roryjamesallen/EuroPi/hardware/surface-mount/europi-surface-mount.kicad_pcb

## KiCad design hardware/surface-mount/europi-surface-mount.kicad_pcb (2026-04-23)

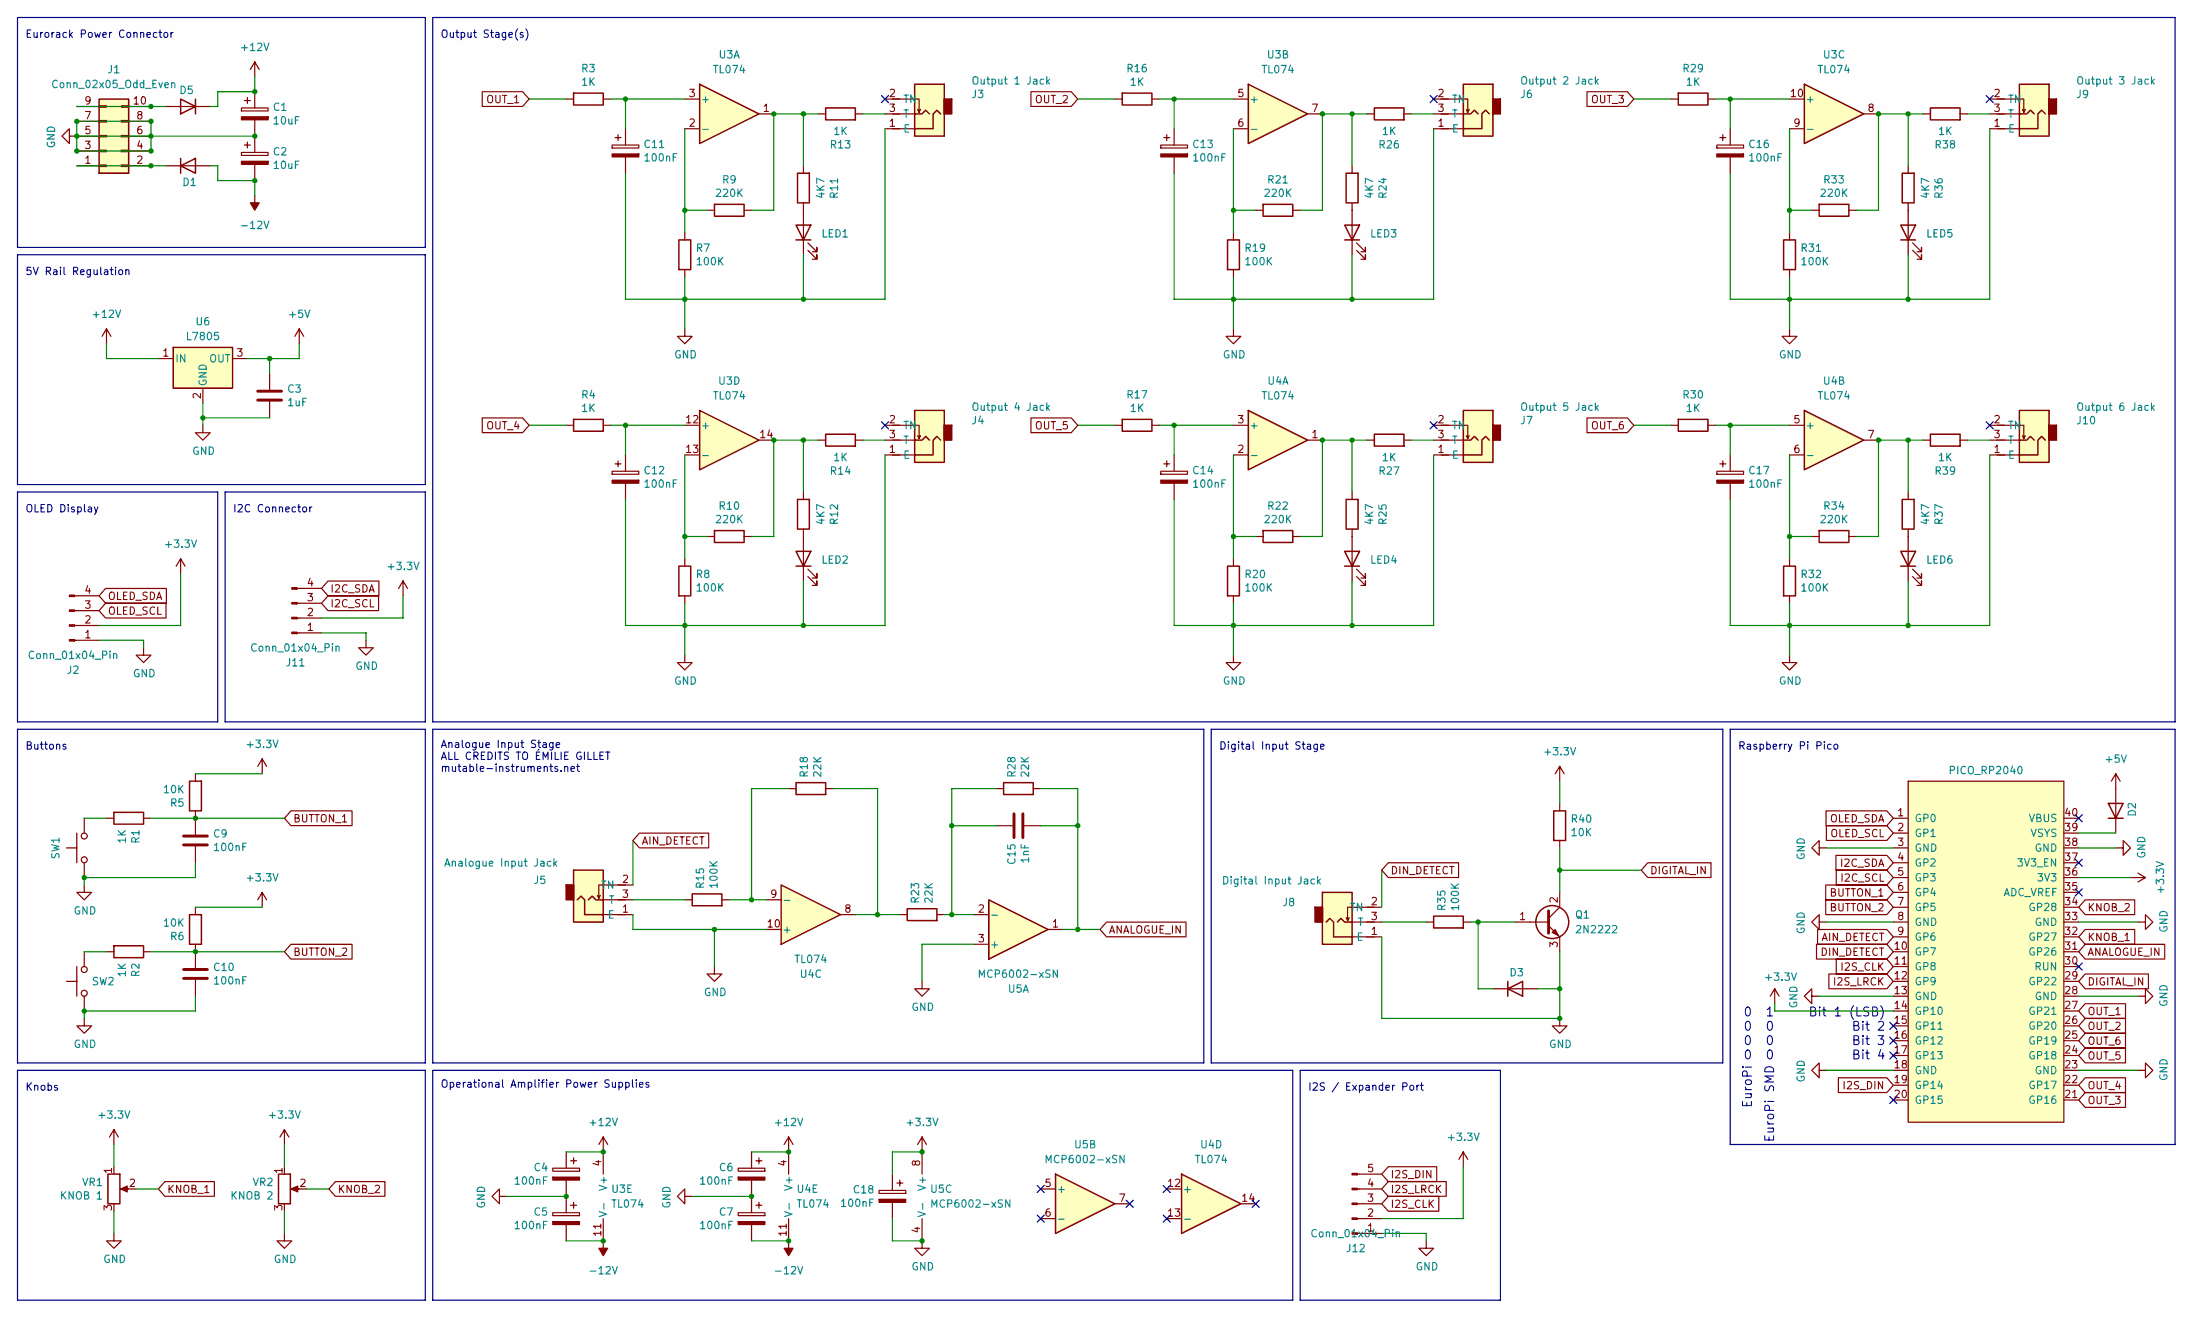
[picture p1: schematic europi-surface-mount.kicad_sch, EuroPi]

Parts:
C1, C2: 10uF; C_0805_2012Metric
C3: 1uF; C_0603_1608Metric
C4, C5, C6, C7, C9, C10, C11, C12, C13, C14, C16, C17, C18: 100nF; C_0603_1608Metric
C15: 1nF; C_0603_1608Metric
D1, D2, D5: D; D_SMA; LCSC Part C5356810
D3: D; D_SMA
J1: Conn_02x05_Odd_Even; power-header-10-pin-unlabelled
J2, J11: Conn_01x04_Pin; PinHeader_1x04_P2.54mm_Vertical
J3: Output 1 Jack; jack-thonkiconn-mono
J4: Output 4 Jack; jack-thonkiconn-mono
J5: Analogue Input Jack; jack-thonkiconn-mono
J6: Output 2 Jack; jack-thonkiconn-mono
J7: Output 5 Jack; jack-thonkiconn-mono
J8: Digital Input Jack; jack-thonkiconn-mono
J9: Output 3 Jack; jack-thonkiconn-mono
J10: Output 6 Jack; jack-thonkiconn-mono
J12: Conn_01x04_Pin; PinHeader_1x05_P2.54mm_Vertical
LED1, LED2, LED3, LED4, LED5, LED6: LED; led-3mm
Q1: 2N2222; SOT-89-3; LCSC Part C21714170
R1, R2, R3, R4, R13, R14, R16, R17, R26, R27, R29, R30, R38, R39: 1K; R_0603_1608Metric
R5, R6, R40: 10K; R_0603_1608Metric
R7, R8, R15, R19, R20, R31, R32, R35: 100K; R_0603_1608Metric
R9, R10, R21, R22, R33, R34: 220K; R_0603_1608Metric
R11, R12, R24, R25, R36, R37: 4K7; R_0603_1608Metric
R18, R23, R28: 22K; R_0603_1608Metric
SW1, SW2: SW_Push; switch-momentary-c&k
U2: PICO_RP2040; raspberry-pi-pico
U3, U4: TL074; SOIC-14_3.9x8.7mm_P1.27mm; LCSC Part C6963
U5: MCP6002-xSN; SOIC-8_3.9x4.9mm_P1.27mm; LCSC Part C7377
U6: L7805; TO-252-2; LCSC Part C7394043
VR1: KNOB 1; potentiometer-9mm
VR2: KNOB 2; potentiometer-9mm

Connections:
+3.3V: C18.1, J2.2, J11.2, J12.2, R5.2, R6.2, R40.1, U2.14 (GP10), U2.36 (3V3), U5.8 (V+), VR1.1, VR2.1
+5V: C3.1, D2.2 (A), U6.3 (OUT)
+12V: C1.1, C4.1, C6.1, D5.1 (K), U3.4 (V+), U4.4 (V+), U6.1 (IN)
-12V: C2.2, C5.2, C7.2, D1.2 (A), U3.11 (V-), U4.11 (V-)
AIN_DETECT: J5.2 (TN), U2.9 (GP6)
ANALOGUE_IN: C15.2, R28.2, U2.31 (GP26), U5.1
BUTTON_1: C9.1, R1.1, R5.1, U2.6 (GP4)
BUTTON_2: C10.1, R2.1, R6.1, U2.7 (GP5)
DIGITAL_IN: Q1.2 (C), R40.2, U2.29 (GP22)
DIN_DETECT: J8.2 (TN), U2.10 (GP7)
GND: C1.2, C2.1, C3.2, C4.2, C5.1, C6.2, C7.1, C9.2, C10.2, C11.2, C12.2, C13.2, C14.2, C16.2, C17.2, C18.2, D3.2 (A), J1.3, J1.4, J1.5, J1.6, J1.7, J1.8, J2.1, J3.1 (E), J4.1 (E), J5.1 (E), J6.1 (E), J7.1 (E), J8.1 (E), J9.1 (E), J10.1 (E), J11.1, J12.1, LED1.1 (K), LED2.1 (K), LED3.1 (K), LED4.1 (K), LED5.1 (K), LED6.1 (K), Q1.3 (E), R7.2, R8.2, R19.2, R20.2, R31.2, R32.2, SW1.1, SW2.1, U2.3 (GND), U2.8 (GND), U2.13 (GND), U2.18 (GND), U2.23 (GND), U2.28 (GND), U2.33 (GND), U2.38 (GND), U4.10 (+), U5.3 (+), U5.4 (V-), U6.2 (GND), VR1.3, VR2.3
I2C_SCL: J11.3, U2.5 (GP3)
I2C_SDA: J11.4, U2.4 (GP2)
I2S_CLK: J12.3, U2.11 (GP8)
I2S_DIN: J12.5, U2.19 (GP14)
I2S_LRCK: J12.4, U2.12 (GP9)
KNOB_1: U2.32 (GP27), VR1.2
KNOB_2: U2.34 (GP28), VR2.2
unnamed: D1.1 (K), J1.1, J1.2
unnamed: D2.1 (K), U2.39 (VSYS)
unnamed: D3.1 (K), Q1.1 (B), R35.2
unnamed: D5.2 (A), J1.9, J1.10
unnamed: J3.3 (T), R13.2
unnamed: J4.3 (T), R14.2
unnamed: J5.3 (T), R15.1
unnamed: J6.3 (T), R26.2
unnamed: J7.3 (T), R27.2
unnamed: J8.3 (T), R35.1
unnamed: J9.3 (T), R38.2
unnamed: J10.3 (T), R39.2
unnamed: LED1.2 (A), R11.1
unnamed: LED2.2 (A), R12.1
unnamed: LED3.2 (A), R24.1
unnamed: LED4.2 (A), R25.1
unnamed: LED5.2 (A), R36.1
unnamed: LED6.2 (A), R37.1
unnamed: R1.2, SW1.2
unnamed: R2.2, SW2.2
unnamed: R10.1, R12.2, R14.1, U3.14
unnamed: R9.1, R11.2, R13.1, U3.1
unnamed: R18.2, R23.1, U4.8
unnamed: R21.1, R24.2, R26.1, U3.7
unnamed: R22.1, R25.2, R27.1, U4.1
unnamed: R33.1, R36.2, R38.1, U3.8
unnamed: R34.1, R37.2, R39.1, U4.7
unnamed: C11.1, R3.1, U3.3 (+)
unnamed: R7.1, R9.2, U3.2 (-)
unnamed: C13.1, R16.1, U3.5 (+)
unnamed: R19.1, R21.2, U3.6 (-)
unnamed: C16.1, R29.1, U3.10 (+)
unnamed: R31.1, R33.2, U3.9 (-)
unnamed: C12.1, R4.1, U3.12 (+)
unnamed: R8.1, R10.2, U3.13 (-)
unnamed: C14.1, R17.1, U4.3 (+)
unnamed: R20.1, R22.2, U4.2 (-)
unnamed: C17.1, R30.1, U4.5 (+)
unnamed: R32.1, R34.2, U4.6 (-)
unnamed: R15.2, R18.1, U4.9 (-)
unnamed: C15.1, R23.2, R28.1, U5.2 (-)
OLED_SCL: J2.3, U2.2 (GP1)
OLED_SDA: J2.4, U2.1 (GP0)
OUT_1: R3.2, U2.27 (GP21)
OUT_2: R16.2, U2.26 (GP20)
OUT_3: R29.2, U2.21 (GP16)
OUT_4: R4.2, U2.22 (GP17)
OUT_5: R17.2, U2.24 (GP18)
OUT_6: R30.2, U2.25 (GP19)

Notes on the sheet:
Eurorack Power Connector
0 1 0 0 0 0 0 0
Operational Amplifier Power Supplies
Raspberry Pi Pico
Digital Input Stage
EuroPi SMD
5V Rail Regulation
Output Stage(s)
I2C Connector
I2S / Expander Port
Buttons
EuroPi
OLED Display
Analogue Input Stage ALL CREDITS TO ÉMILIE GILLET mutable-instruments.net
Knobs
Bit 1 (LSB) Bit 2 Bit 3 Bit 4

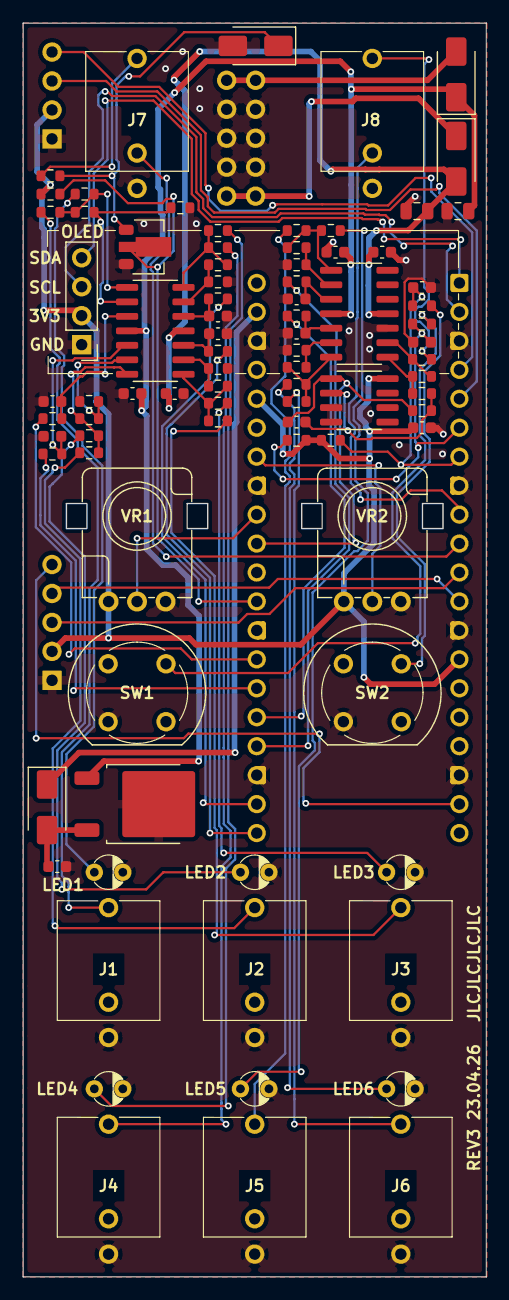
[picture p2: board europi-surface-mount.kicad_pcb from above]

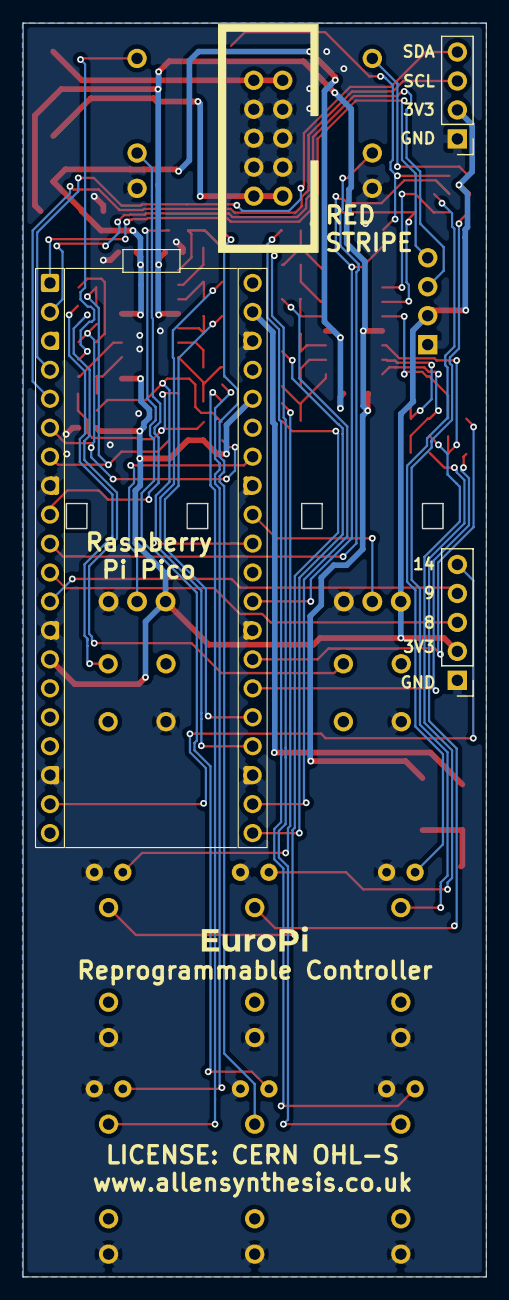
[picture p3: board europi-surface-mount.kicad_pcb from below]

Board: 2 copper layers, 40.6 x 110.0 mm, 89 parts (4 on the bottom side), 67 nets.
