roryjamesallen/EuroPi/hardware/EuroPi-X/development/output stage/output stage.kicad_pcb

## KiCad design hardware/EuroPi-X/development/output stage/output stage.kicad_pcb (2024-01-31)

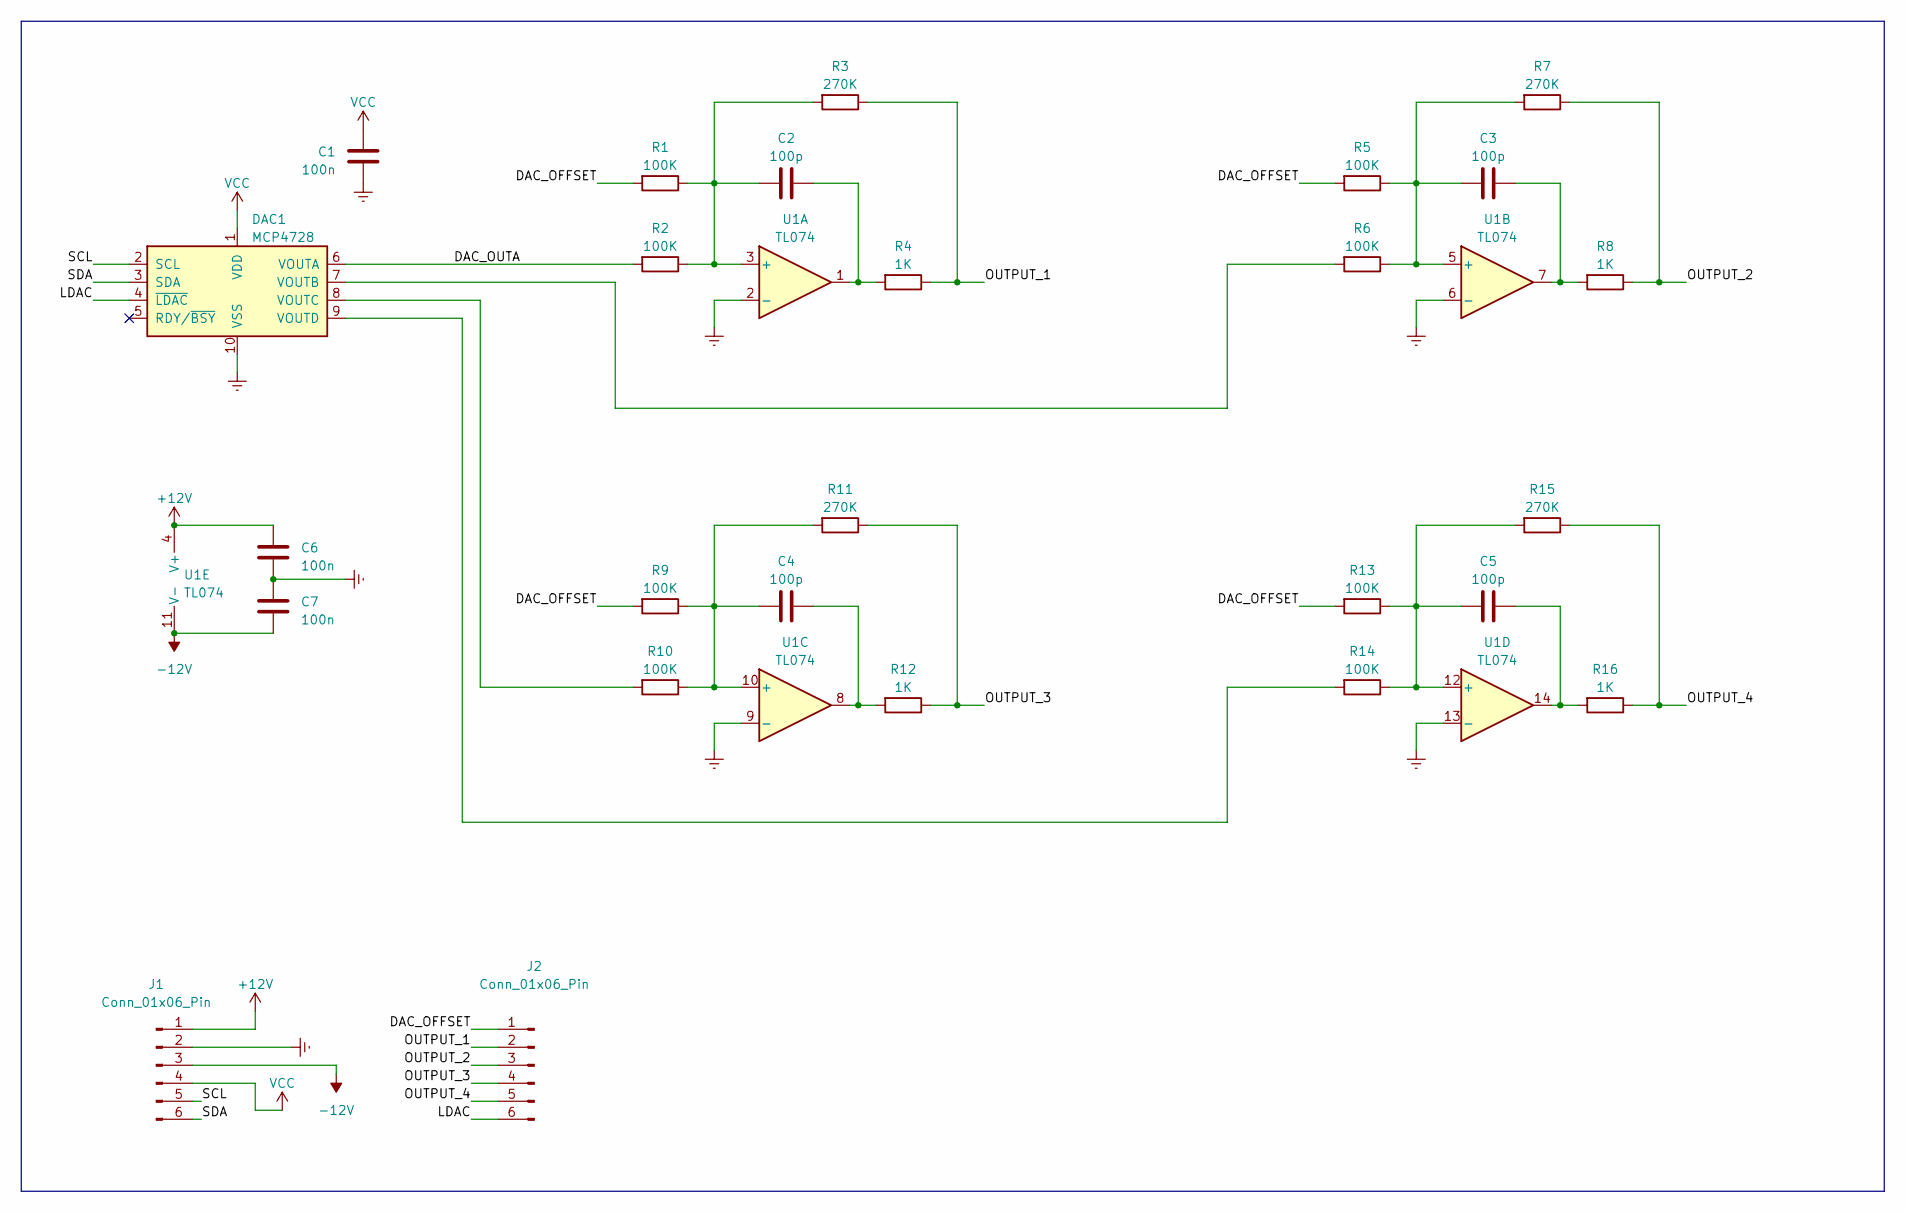
[picture p4: schematic output stage.kicad_sch]

Parts:
C1, C6, C7: 100n; C_0402_1005Metric; JLC C1525
C2, C3, C4, C5: 100p; C_0402_1005Metric; JLC C1546
DAC1: MCP4728; MSOP-10_3x3mm_P0.5mm; JLC C478093
J1, J2: Conn_01x06_Pin; PinHeader_1x06_P2.54mm_Vertical
R1, R2, R5, R6, R9, R10, R13, R14: 100K; R_0402_1005Metric; JLC C25741
R3, R7, R11, R15: 270K; R_0402_1005Metric; JLC C170277
R4, R8, R12, R16: 1K; R_0402_1005Metric; JLC C11702
U1: TL074; SOIC-14_3.9x8.7mm_P1.27mm; JLC C6963

Connections:
+12V: C6.1, J1.1, U1.4 (V+)
-12V: C7.2, J1.3, U1.11 (V-)
/DAC_OFFSET: J2.1, R1.2, R5.2, R9.2, R13.2
/DAC_OUTA: DAC1.6 (VOUTA), R2.2
/LDAC: DAC1.4 (~LDAC), J2.6
/OUTPUT_1: J2.2, R3.1, R4.1
/OUTPUT_2: J2.3, R7.1, R8.1
/OUTPUT_3: J2.4, R11.1, R12.1
/OUTPUT_4: J2.5, R15.1, R16.1
/SCL: DAC1.2 (SCL), J1.5
/SDA: DAC1.3 (SDA), J1.6
Earth: C1.2, C6.2, C7.1, DAC1.10 (VSS), J1.2, U1.2 (-), U1.6 (-), U1.9 (-), U1.13 (-)
unnamed: C2.2, R4.2, U1.1
unnamed: C3.2, R8.2, U1.7
unnamed: C4.2, R12.2, U1.8
unnamed: C5.2, R16.2, U1.14
unnamed: DAC1.7 (VOUTB), R6.2
unnamed: DAC1.8 (VOUTC), R10.2
unnamed: DAC1.9 (VOUTD), R14.2
unnamed: C2.1, R1.1, R2.1, R3.2, U1.3 (+)
unnamed: C3.1, R5.1, R6.1, R7.2, U1.5 (+)
unnamed: C4.1, R9.1, R10.1, R11.2, U1.10 (+)
unnamed: C5.1, R13.1, R14.1, R15.2, U1.12 (+)
VCC: C1.1, DAC1.1 (VDD), J1.4

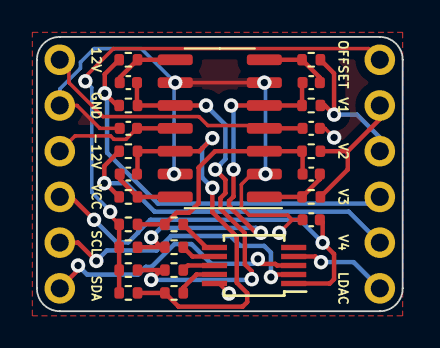
[picture p5: board output stage.kicad_pcb from above]

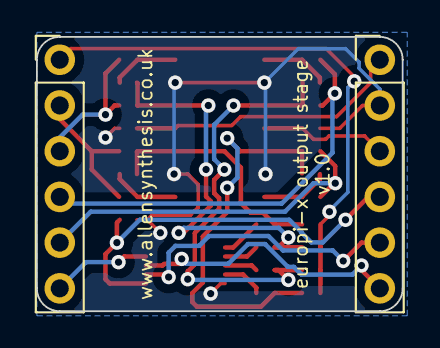
[picture p6: board output stage.kicad_pcb from below]

Board: 2 copper layers, 20.3 x 15.2 mm, 27 parts (2 on the bottom side), 24 nets.
