roryjamesallen/EuroPi/hardware/EuroPi-X/development/jack pcb/jack pcb.kicad_pcb

## KiCad design hardware/EuroPi-X/development/jack pcb/jack pcb.kicad_pcb (2024-01-25)

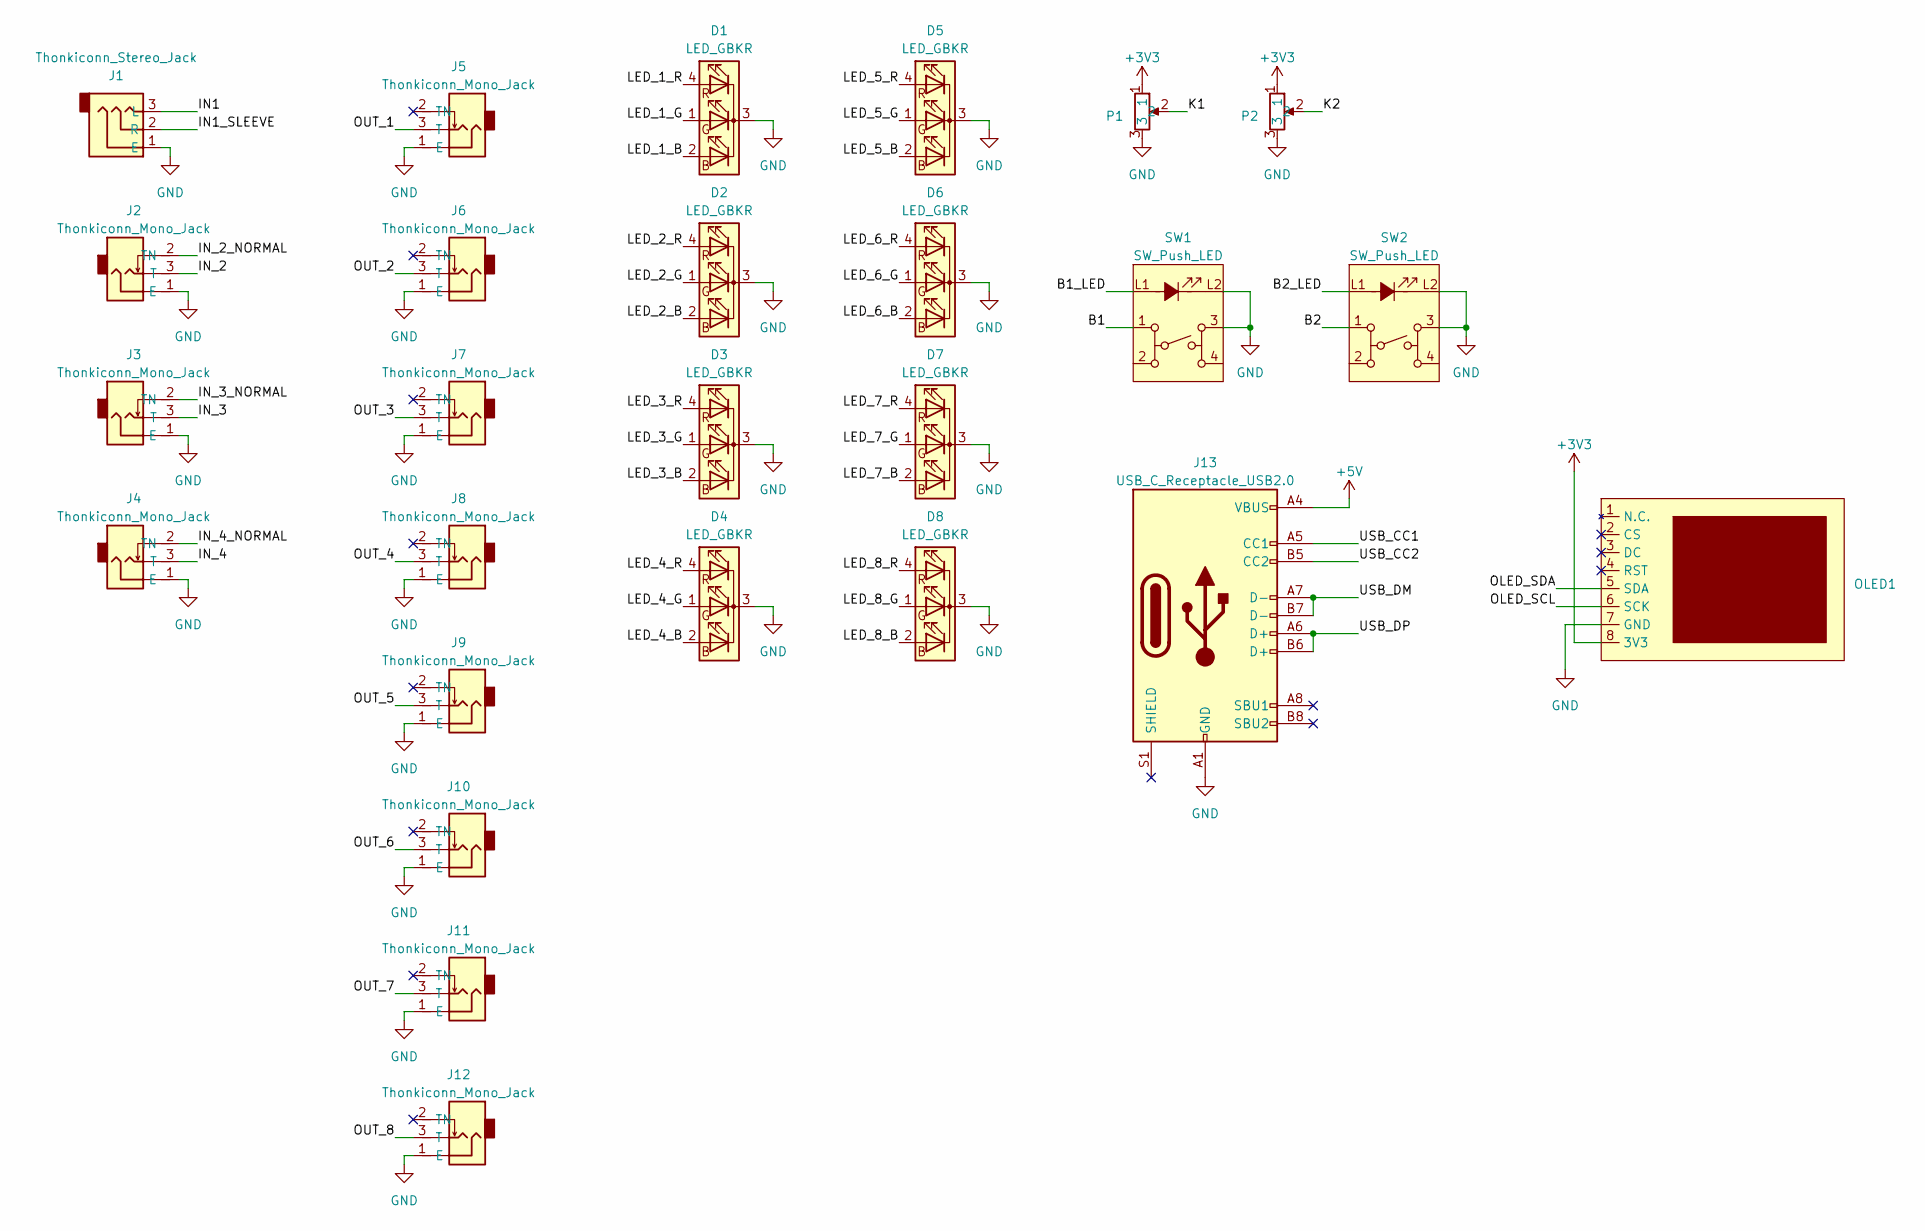
[picture p9: schematic jack pcb.kicad_sch]

Parts:
D1, D2, D3, D4, D5, D6, D7, D8: LED_GBKR; 254-5726 RGB Led 5mm
J1: Thonkiconn_Stereo_Jack; Thonkiconn Stereo Jack
J2, J3, J4, J5, J6, J7, J8, J9, J10, J11, J12: Thonkiconn_Mono_Jack; Thonkiconn Mono Jack
J13: USB_C_Receptacle_USB2.0; USB_C_Vertical_GT-USB-7038X USB
OLED1: Enoki OLED SSD1306 128x64
P1, P2: Potentiometer_9mm_Vertical_Linear; potentiometer-9mm_2hp
SW1, SW2: SW_Push_LED; switch-momentary-c&k-illuminated

Connections:
+3V3: OLED1.8 (3V3), P1.1, P2.1
+5V: J13.A4 (VBUS), J13.A9 (VBUS), J13.B4 (VBUS), J13.B9 (VBUS)
/B1: SW1.1
/B1_LED: SW1.L1 (A)
/B2: SW2.1
/B2_LED: SW2.L1 (A)
/IN1: J1.3 (L)
/IN1_SLEEVE: J1.2 (R)
/IN_2: J2.3 (T)
/IN_2_NORMAL: J2.2 (TN)
/IN_3: J3.3 (T)
/IN_3_NORMAL: J3.2 (TN)
/IN_4: J4.3 (T)
/IN_4_NORMAL: J4.2 (TN)
/K1: P1.2
/K2: P2.2
/LED_1_B: D1.2 (BA)
/LED_1_G: D1.1 (GA)
/LED_1_R: D1.4 (RA)
/LED_2_B: D2.2 (BA)
/LED_2_G: D2.1 (GA)
/LED_2_R: D2.4 (RA)
/LED_3_B: D3.2 (BA)
/LED_3_G: D3.1 (GA)
/LED_3_R: D3.4 (RA)
/LED_4_B: D4.2 (BA)
/LED_4_G: D4.1 (GA)
/LED_4_R: D4.4 (RA)
/LED_5_B: D5.2 (BA)
/LED_5_G: D5.1 (GA)
/LED_5_R: D5.4 (RA)
/LED_6_B: D6.2 (BA)
/LED_6_G: D6.1 (GA)
/LED_6_R: D6.4 (RA)
/LED_7_B: D7.2 (BA)
/LED_7_G: D7.1 (GA)
/LED_7_R: D7.4 (RA)
/LED_8_B: D8.2 (BA)
/LED_8_G: D8.1 (GA)
/LED_8_R: D8.4 (RA)
/OLED_SCL: OLED1.6 (SCK)
/OLED_SDA: OLED1.5 (SDA)
/OUT_1: J5.3 (T)
/OUT_2: J6.3 (T)
/OUT_3: J7.3 (T)
/OUT_4: J8.3 (T)
/OUT_5: J9.3 (T)
/OUT_6: J10.3 (T)
/OUT_7: J11.3 (T)
/OUT_8: J12.3 (T)
/USB_CC1: J13.A5 (CC1)
/USB_CC2: J13.B5 (CC2)
/USB_DM: J13.A7 (D-), J13.B7 (D-)
/USB_DP: J13.A6 (D+), J13.B6 (D+)
GND: D1.3 (K), D2.3 (K), D3.3 (K), D4.3 (K), D5.3 (K), D6.3 (K), D7.3 (K), D8.3 (K), J1.1 (E), J2.1 (E), J3.1 (E), J4.1 (E), J5.1 (E), J6.1 (E), J7.1 (E), J8.1 (E), J9.1 (E), J10.1 (E), J11.1 (E), J12.1 (E), J13.A1 (GND), J13.A12 (GND), J13.B1 (GND), J13.B12 (GND), OLED1.7 (GND), P1.3, P2.3, SW1.3, SW1.L2 (K), SW2.3, SW2.L2 (K)

Board: 2 copper layers, 26 parts (0 on the bottom side), 5 nets, no tracks yet.
