roryjamesallen/EuroPi/hardware/EuroPi-X/development/neopixels/neopixels.kicad_pcb

## KiCad design hardware/EuroPi-X/development/neopixels/neopixels.kicad_pcb (2024-01-21)

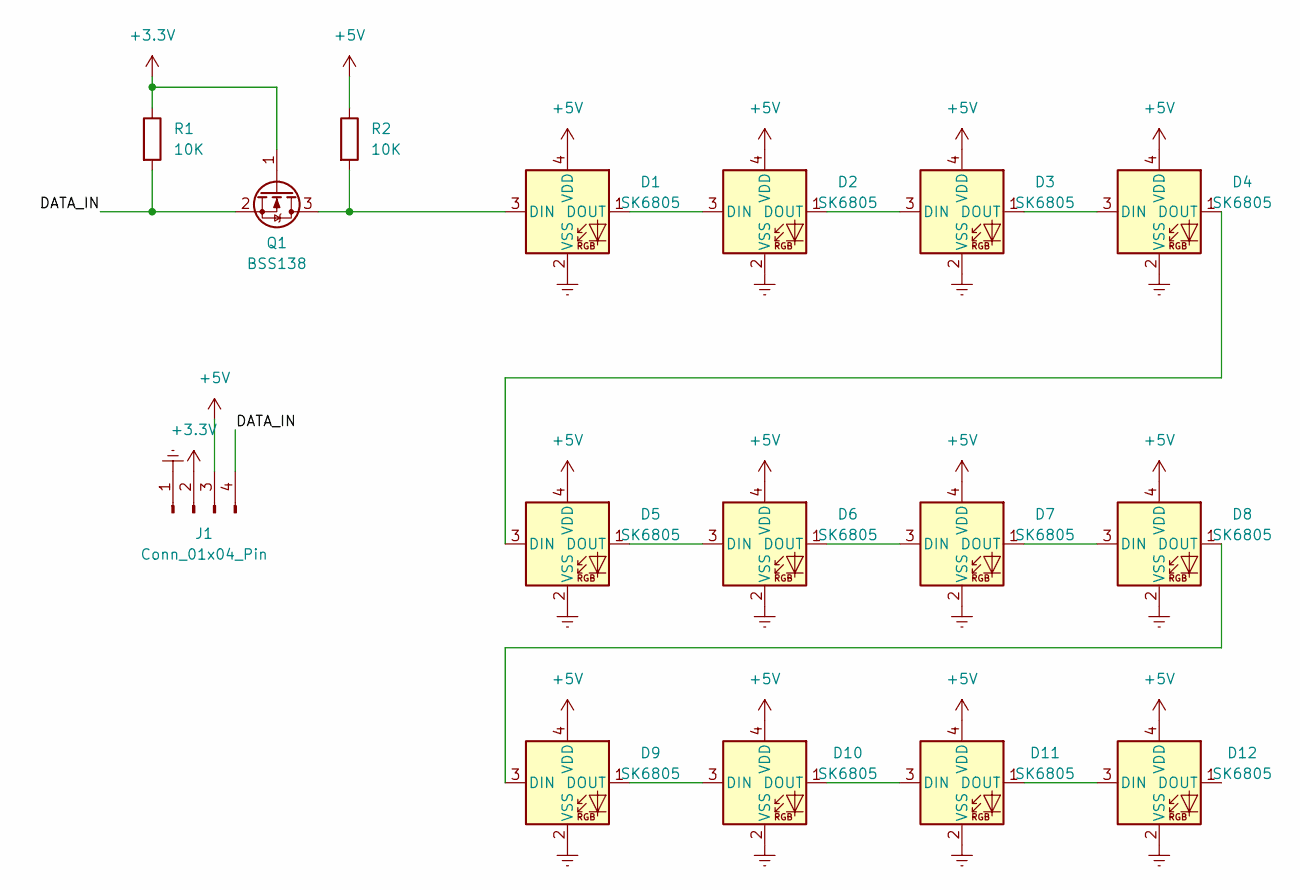
[picture p10: schematic neopixels.kicad_sch]

Parts:
D1, D2, D3, D4, D5, D6, D7, D8, D9, D10, D11, D12: SK6805; LED_SK6805_PLCC4_2.4x2.7mm_P1.3mm; JLC C2890036
J1: Conn_01x04_Pin; PinHeader_1x04_P2.54mm_Vertical
Q1: BSS138; SOT-23
R1, R2: 10K; R_0402_1005Metric; JLC C25744

Connections:
+3.3V: J1.2, Q1.1 (G), R1.1
+5V: D1.4 (VDD), D2.4 (VDD), D3.4 (VDD), D4.4 (VDD), D5.4 (VDD), D6.4 (VDD), D7.4 (VDD), D8.4 (VDD), D9.4 (VDD), D10.4 (VDD), D11.4 (VDD), D12.4 (VDD), J1.3, R2.1
/DATA_IN: J1.4, Q1.2 (S), R1.2
Earth: D1.2 (VSS), D2.2 (VSS), D3.2 (VSS), D4.2 (VSS), D5.2 (VSS), D6.2 (VSS), D7.2 (VSS), D8.2 (VSS), D9.2 (VSS), D10.2 (VSS), D11.2 (VSS), D12.2 (VSS), J1.1
unnamed: D1.3 (DIN), Q1.3 (D), R2.2
unnamed: D1.1 (DOUT), D2.3 (DIN)
unnamed: D2.1 (DOUT), D3.3 (DIN)
unnamed: D3.1 (DOUT), D4.3 (DIN)
unnamed: D4.1 (DOUT), D5.3 (DIN)
unnamed: D5.1 (DOUT), D6.3 (DIN)
unnamed: D6.1 (DOUT), D7.3 (DIN)
unnamed: D7.1 (DOUT), D8.3 (DIN)
unnamed: D8.1 (DOUT), D9.3 (DIN)
unnamed: D9.1 (DOUT), D10.3 (DIN)
unnamed: D10.1 (DOUT), D11.3 (DIN)
unnamed: D11.1 (DOUT), D12.3 (DIN)

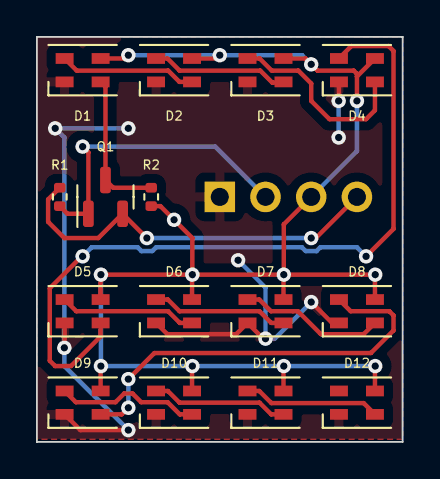
[picture p11: board neopixels.kicad_pcb from above]

Board: 2 copper layers, 20.3 x 22.5 mm, 16 parts (1 on the bottom side), 16 nets.
