roryjamesallen/EuroPi/hardware/EuroPi-X/development/analogue_switches/analogue_switches.kicad_pcb

## KiCad design hardware/EuroPi-X/development/analogue_switches/analogue_switches.kicad_pcb (2024-01-15)

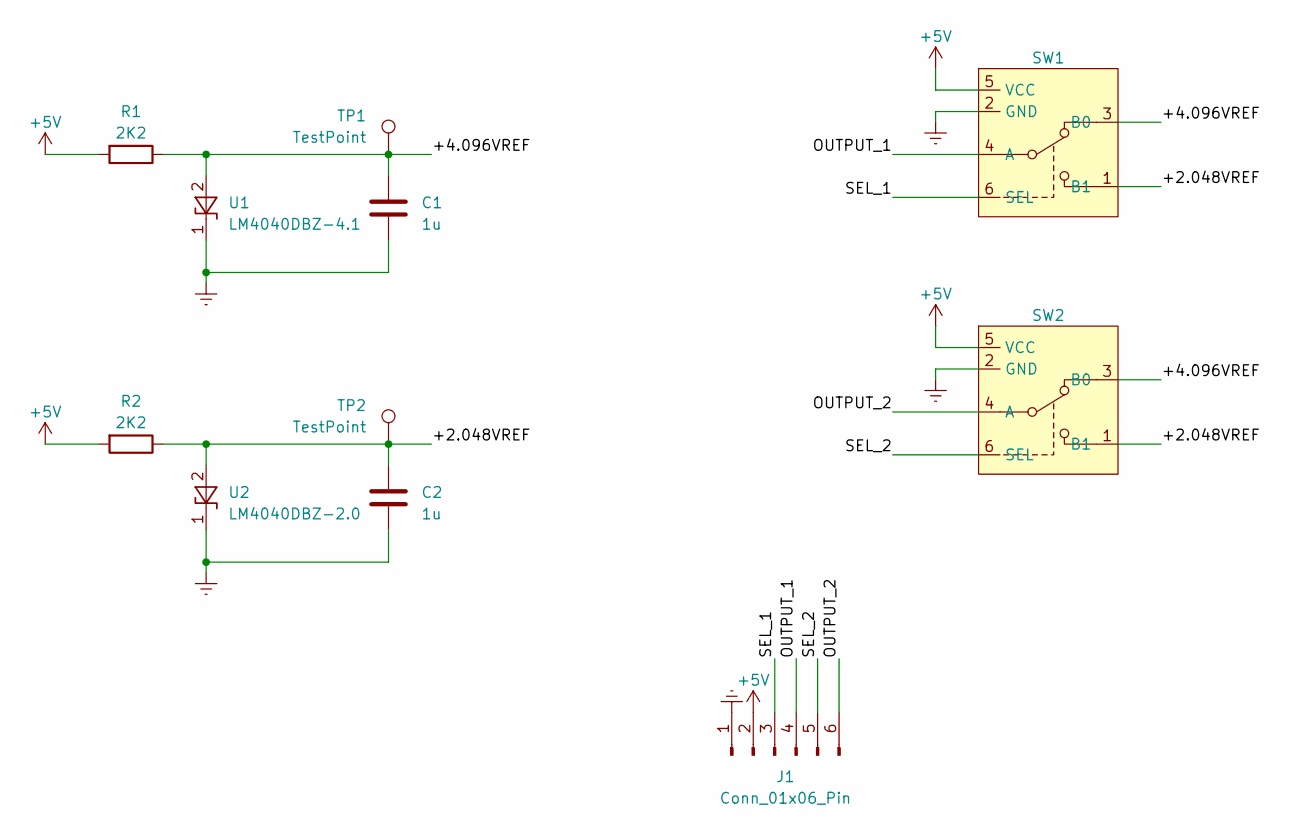
[picture p12: schematic analogue_switches.kicad_sch]

Parts:
C1, C2: 1u; C_0402_1005Metric; JLC C52923
J1: Conn_01x06_Pin; PinHeader_1x06_P2.54mm_Vertical
R1, R2: 2K2; R_0402_1005Metric; JLC C25879
SW1, SW2: SOT-363_SC-70-6; JLC C213161
TP1, TP2: TestPoint; TestPoint_Pad_2.0x2.0mm
U1: LM4040DBZ-4.1; SOT-23; JLC C202194
U2: LM4040DBZ-2.0; SOT-23; JLC C144273

Connections:
+5V: J1.2, R1.2, R2.2, SW1.5 (VCC), SW2.5 (VCC)
/+2.048VREF: C2.1, R2.1, SW1.1 (B1), SW2.1 (B1), TP2.1, U2.2 (A)
/+4.096VREF: C1.1, R1.1, SW1.3 (B0), SW2.3 (B0), TP1.1, U1.2 (A)
/OUTPUT_1: J1.4, SW1.4 (A)
/OUTPUT_2: J1.6, SW2.4 (A)
/SEL_1: J1.3, SW1.6 (SEL)
/SEL_2: J1.5, SW2.6 (SEL)
Earth: C1.2, C2.2, J1.1, SW1.2 (GND), SW2.2 (GND), U1.1 (K), U2.1 (K)

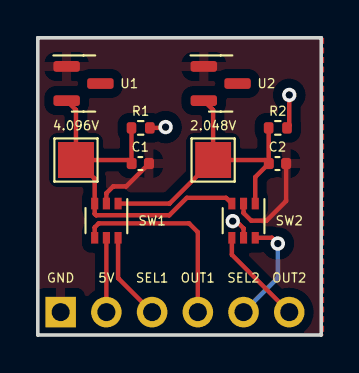
[picture p13: board analogue_switches.kicad_pcb from above]

Board: 2 copper layers, 15.7 x 16.5 mm, 11 parts (1 on the bottom side), 8 nets.
