roryjamesallen/EuroPi/hardware/EuroPi-X/kicad/EuroPi-X.kicad_pcb

## KiCad design hardware/EuroPi-X/kicad/EuroPi-X.kicad_pcb (2023-05-05)

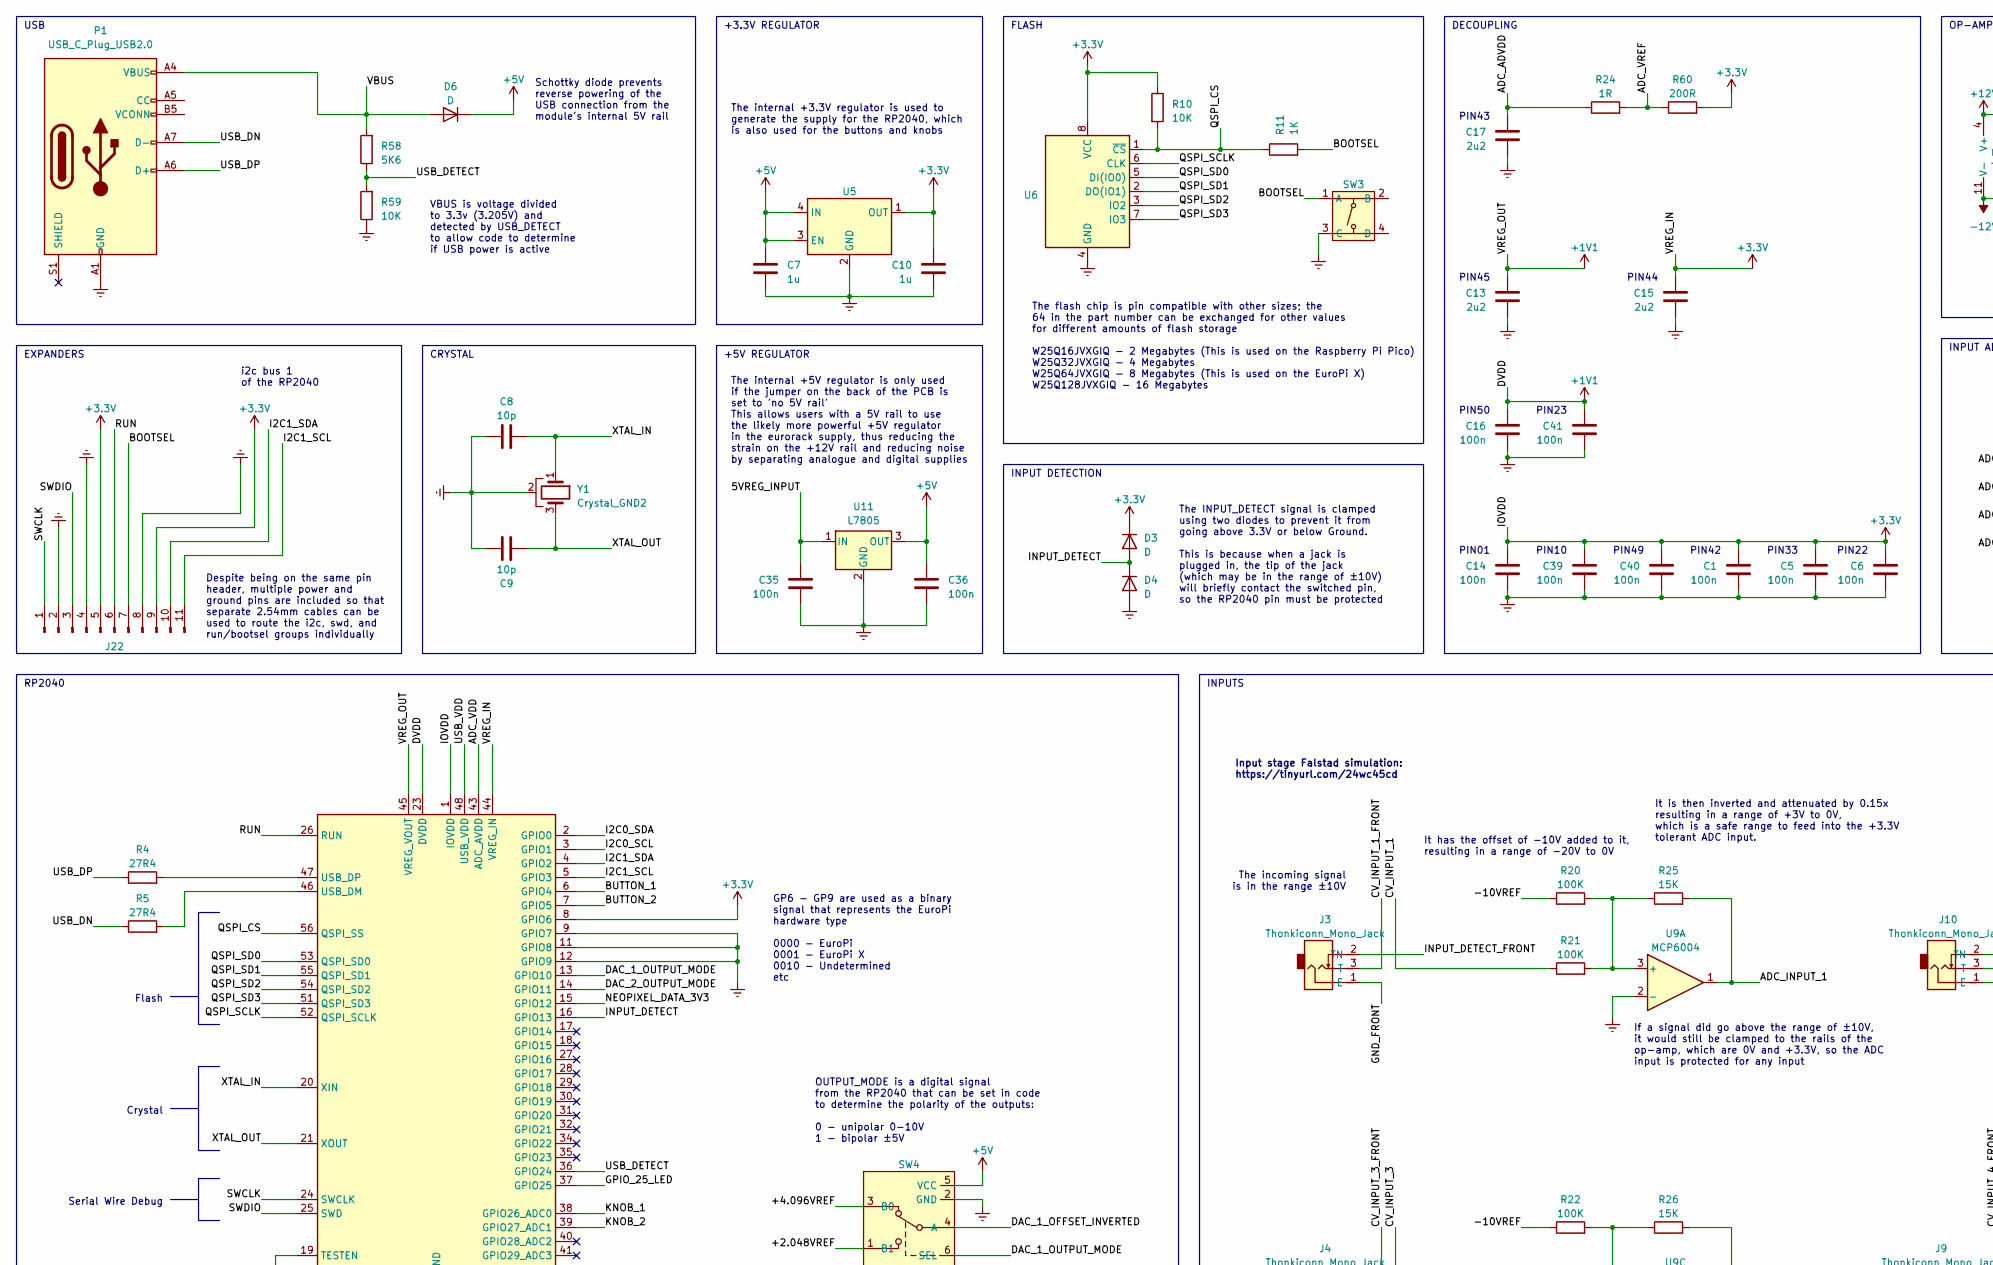
[picture p14: schematic EuroPi-X.kicad_sch, EuroPi X, part in row 1, column 1]

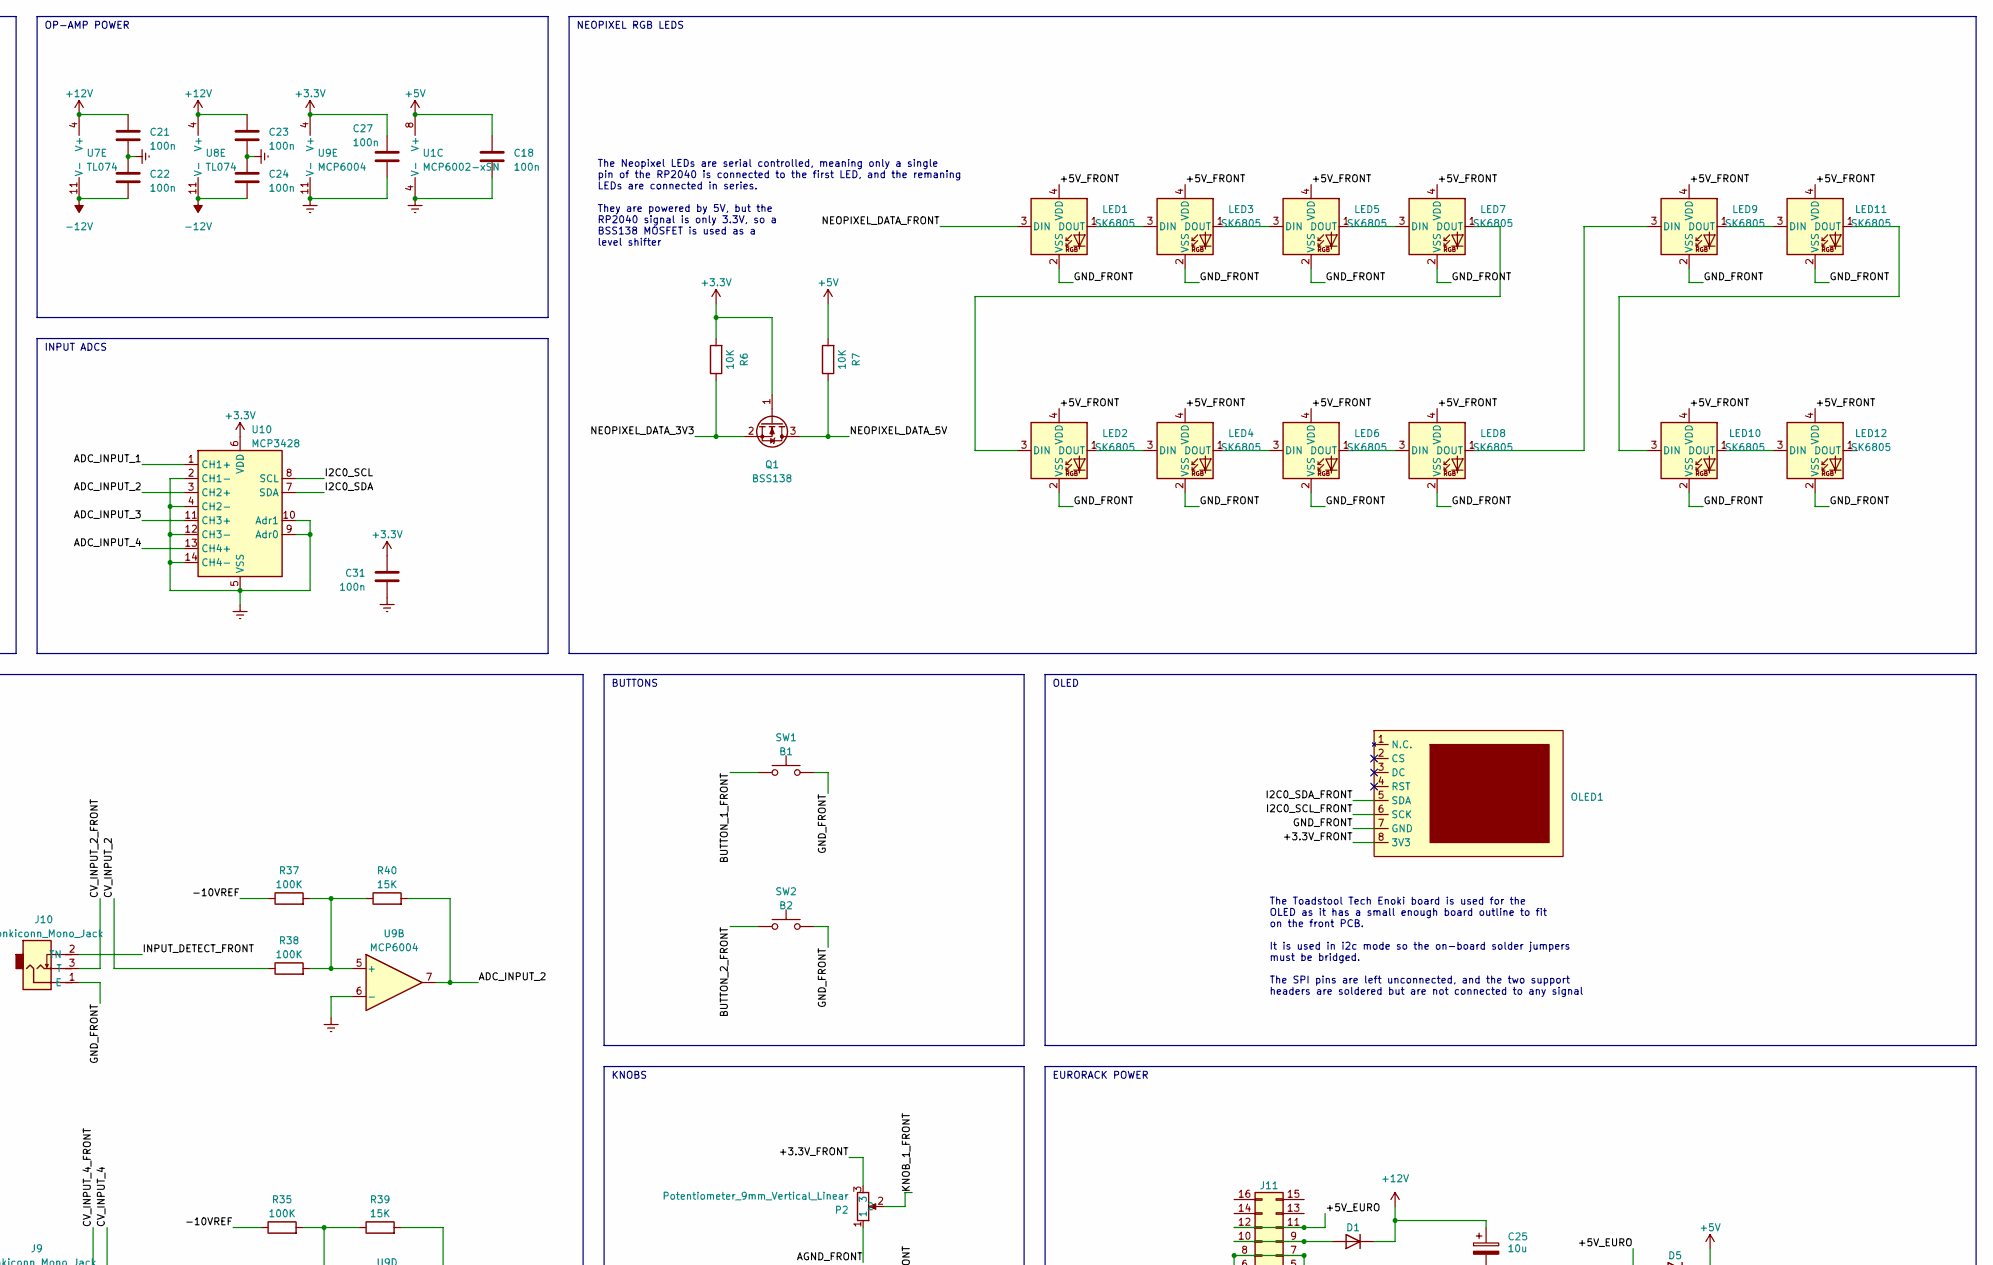
[picture p15: schematic EuroPi-X.kicad_sch, EuroPi X, part in row 1, column 2]

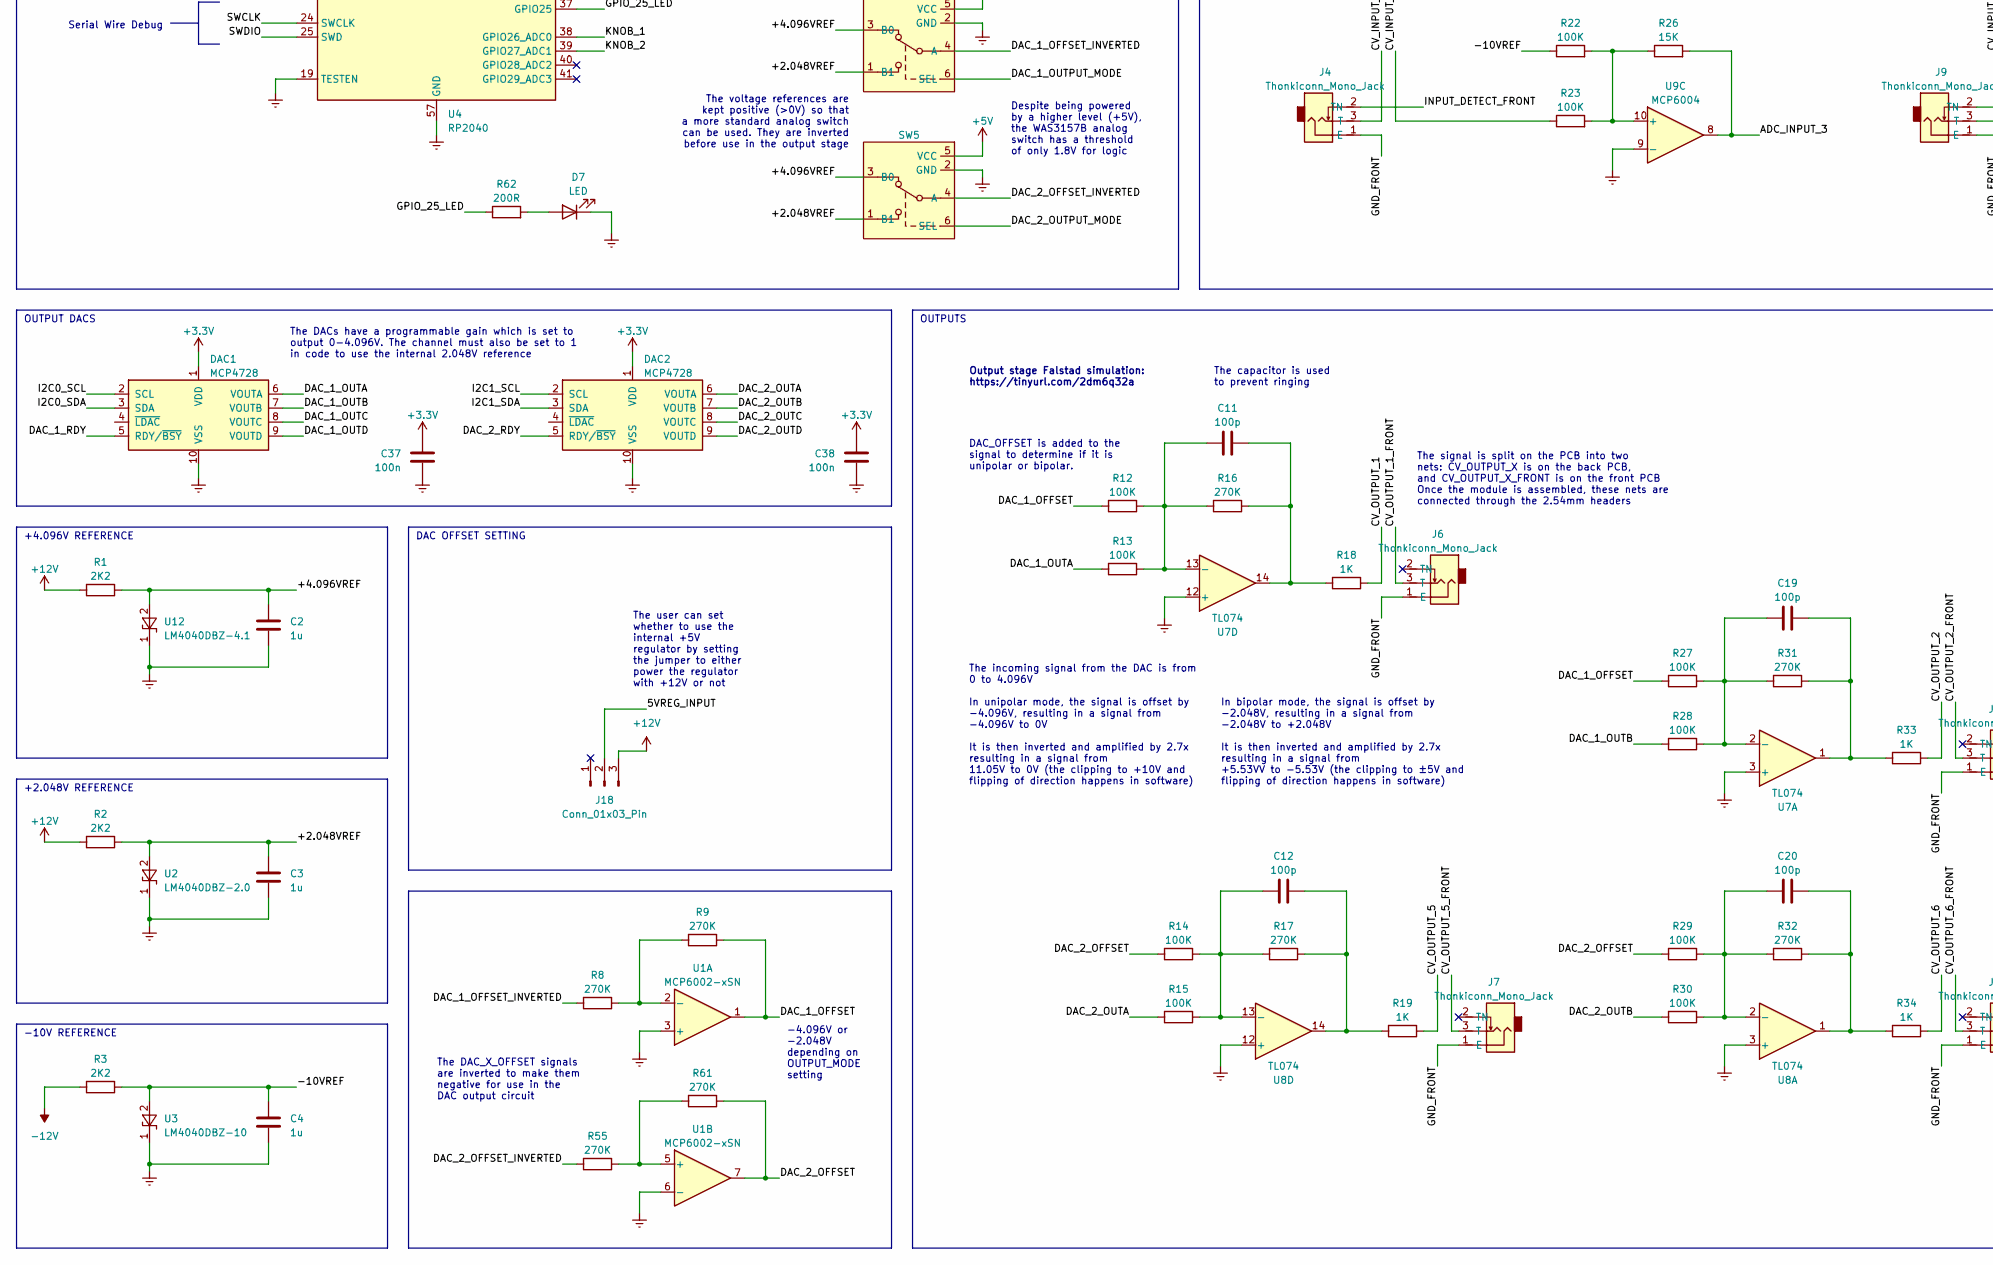
[picture p16: schematic EuroPi-X.kicad_sch, EuroPi X, part in row 2, column 1]

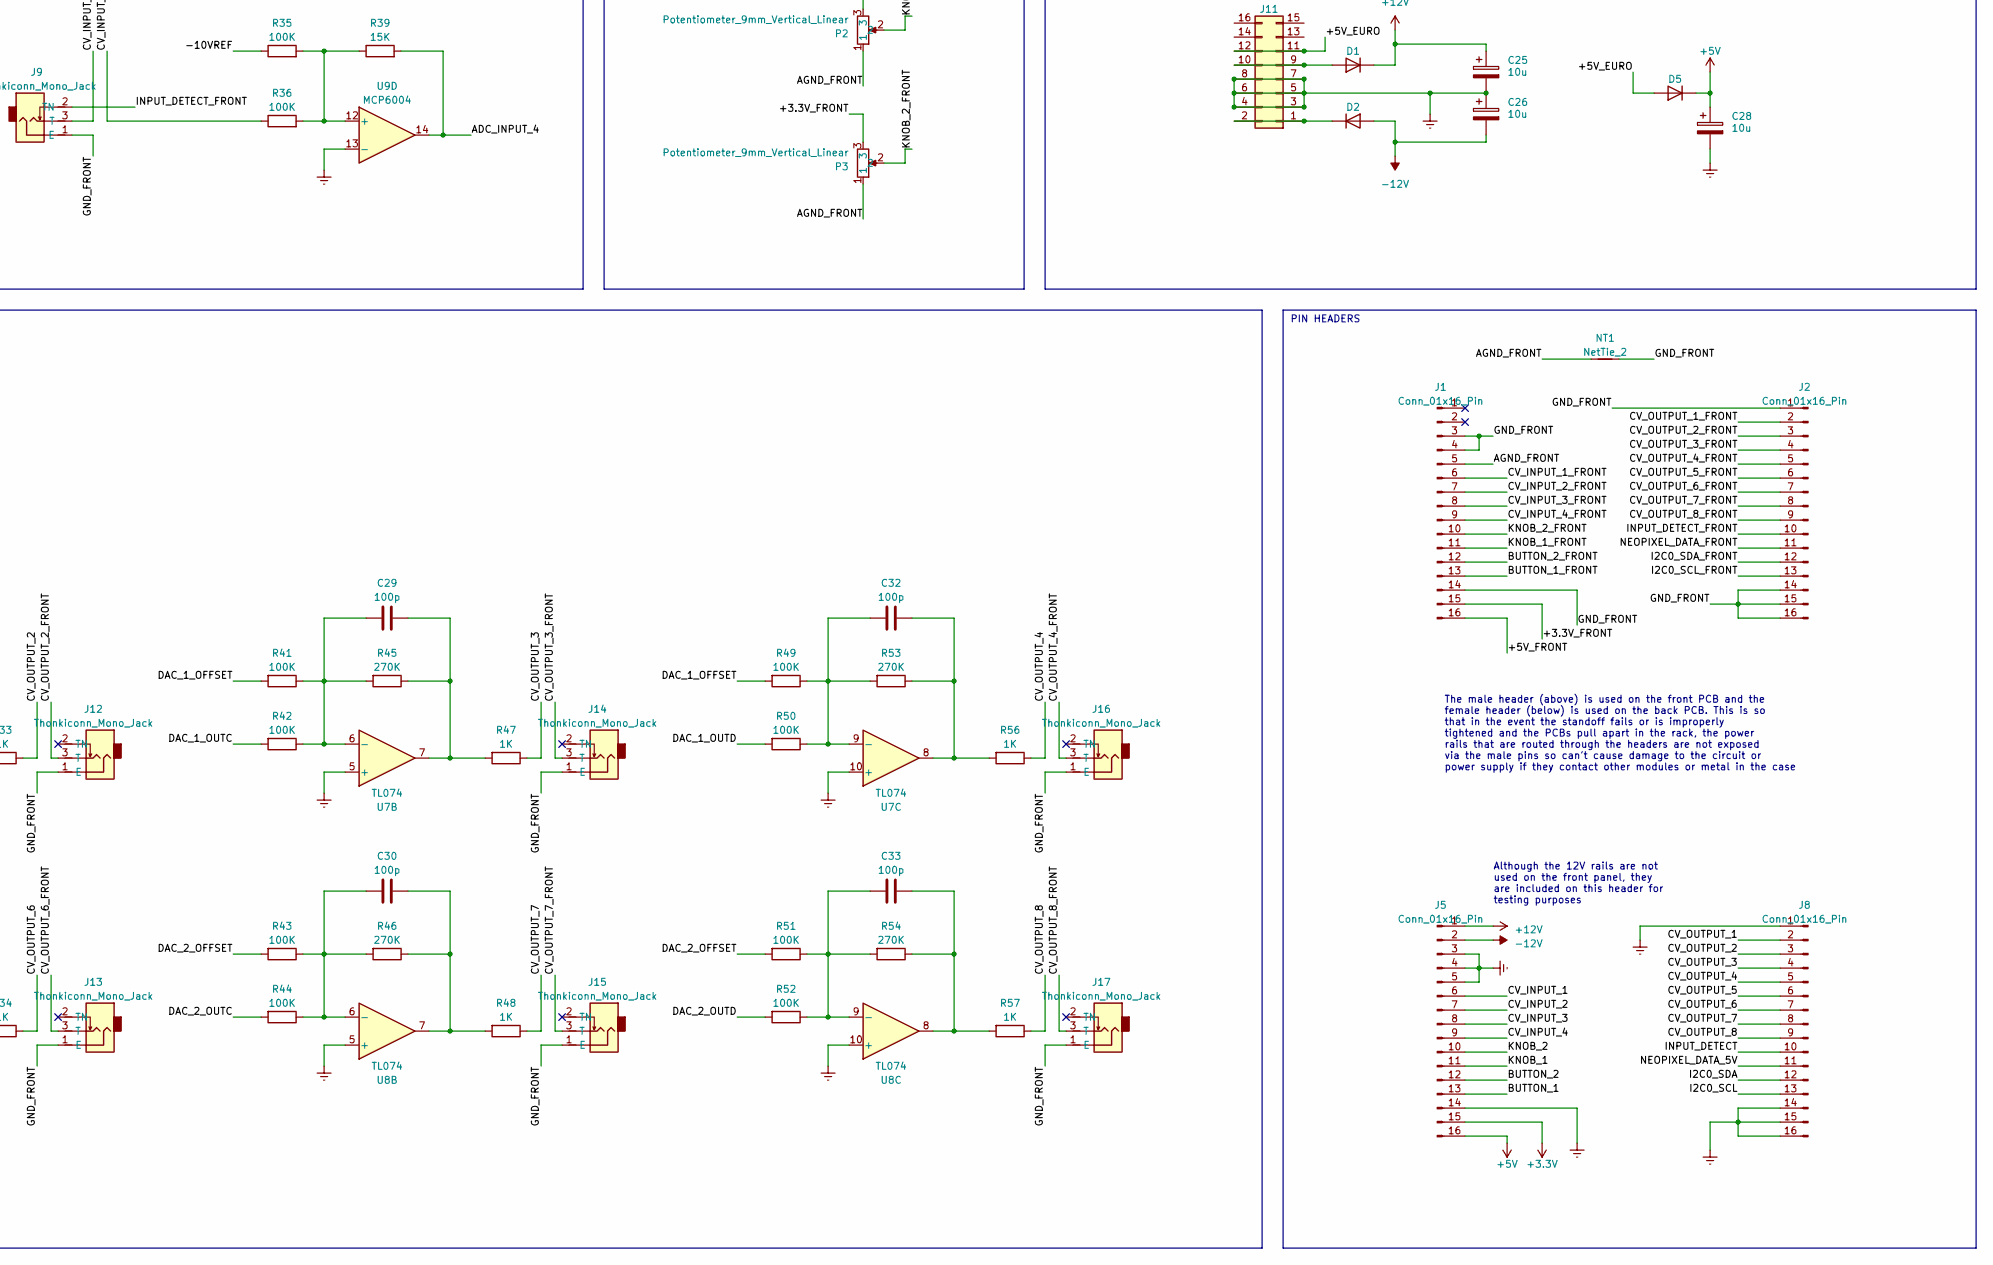
[picture p17: schematic EuroPi-X.kicad_sch, EuroPi X, part in row 2, column 2]

Parts:
C1, C5, C6, C14, C16, C18, C21, C22, C23, C24, C27, C31, C35, C36, C37, C38, C39, C40, C41: 100n; C_0402_1005Metric; JLC C1525
C2, C3, C4, C7, C10: 1u; C_0402_1005Metric; JLC C52923
C8, C9: 10p; C_0402_1005Metric; JLC C32949
C11, C12, C19, C20, C29, C30, C32, C33: 100p; C_0402_1005Metric; JLC C1546
C13, C15, C17: 2u2; C_0402_1005Metric; JLC C12530
C25, C26, C28: 10u; C_0805_2012Metric; JLC C15850
D1, D2, D5: type="D" model="DIODE" lib=""; D_SMA; JLC C95872
D3, D4, D6: D; D_SOD-123; JLC C8598
D7: LED; JLC C2286
DAC1, DAC2: MCP4728; MSOP-10_3x3mm_P0.5mm; JLC C478093
J1, J2: Conn_01x16_Pin; PinHeader_1x16_P2.54mm_Vertical
J3, J4, J6, J7, J9, J10, J12, J13, J14, J15, J16, J17: Thonkiconn_Mono_Jack; Thonkiconn Mono Jack
J5, J8: Conn_01x16_Pin; PinSocket_1x16_P2.54mm_Vertical
J11: Conn_02x08_Odd_Even; Eurorack Power Header 16 Pin Unlabeled
J18: Conn_01x03_Pin; PinHeader_1x03_P2.54mm_Vertical
J22: Conn_01x11_Pin; PinHeader_1x11_P2.54mm_Vertical
LED1, LED2, LED3, LED4, LED5, LED6, LED7, LED8, LED9, LED10, LED11, LED12: SK6805; LED_SK6805_PLCC4_2.4x2.7mm_P1.3mm
NT1: NetTie_2; NetTie-2_SMD_Pad0.5mm
OLED1: Enoki OLED SSD1306 128x64
P1: USB_C_Plug_USB2.0; USB_C_Receptacle_G-Switch_GT-USB-7010ASV; JLC C2927037
P2, P3: Potentiometer_9mm_Vertical_Linear; Potentiometer 9mm Vertical Linear Centred
Q1: BSS138; SOT-23; JLC C112239
R1, R2, R3: 2K2; R_0402_1005Metric; JLC C25879
R4, R5: 27R4; R_0402_1005Metric; JLC C25100
R6, R7, R10, R59: 10K; R_0402_1005Metric; JLC C25744
R8, R9, R16, R17, R31, R32, R45, R46, R53, R54, R55, R61: 270K; R_0402_1005Metric; JLC C170277
R11, R18, R19, R33, R34, R47, R48, R56, R57: 1K; R_0402_1005Metric; JLC C11702
R12, R13, R14, R15, R20, R21, R22, R23, R27, R28, R29, R30, R35, R36, R37, R38, R41, R42, R43, R44, R49, R50, R51, R52: 100K; R_0402_1005Metric; JLC C25741
R24: 1R; R_0402_1005Metric; JLC C25086
R25, R26, R39, R40: 15K; R_0402_1005Metric; JLC C25756
R58: 5K6; R_0402_1005Metric; JLC C25092
R60, R62: 200R; R_0402_1005Metric; JLC C25087
SW1: B1; Switch Tactile Momentary C&K
SW2: B2; Switch Tactile Momentary C&K
SW3: TS-1187A-B-A-B; JLC C318884
SW4, SW5: SOT-363_SC-70-6; JLC C213161
U1: MCP6002-xSN; SOIC-8_3.9x4.9mm_P1.27mm; JLC Rotation Offset 270
U2: LM4040DBZ-2.0; SOT-23; JLC C144273
U3: LM4040DBZ-10; SOT-23; JLC C129969
U4: RP2040; QFN-56-1EP_7x7mm_P0.4mm_EP3.2x3.2mm; JLC C2040
U5: SOT-23-3; JLC C5446
U6: SOIC-8_5.23x5.23mm_P1.27mm; JLC C2940195
U7, U8: TL074; SOIC-14_3.9x8.7mm_P1.27mm; JLC C6963
U9: MCP6004; TSSOP-14_4.4x5mm_P0.65mm; JLC C50282
U10: MCP3428; SOIC-14_3.9x8.7mm_P1.27mm; JLC C560166
U11: L7805; TO-252-2; JLC C58069
U12: LM4040DBZ-4.1; SOT-23; JLC C202194
Y1: Crystal_GND2; Crystal_SMD_3225-4Pin_3.2x2.5mm; JLC C9002

Connections:
+1V1: C13.1, C16.1, C41.1, U4.23 (DVDD), U4.45 (VREG_VOUT), U4.50 (DVDD)
+3.3V: C1.1, C5.1, C6.1, C10.1, C14.1, C15.1, C27.1, C31.1, C37.1, C38.1, C39.1, C40.1, D3.1 (K), DAC1.1 (VDD), DAC2.1 (VDD), J5.15, J22.5, J22.9, Q1.1 (G), R6.2, R10.1, R60.2, U4.1 (IOVDD), U4.8 (GPIO6), U4.10 (IOVDD), U4.22 (IOVDD), U4.33 (IOVDD), U4.42 (IOVDD), U4.44 (VREG_IN), U4.49 (IOVDD), U5.1 (OUT), U6.8 (VCC), U9.4 (V+), U10.6 (VDD)
+5V: C7.1, C18.1, C28.1, C36.1, D5.2 (K), D6.1 (K), J5.16, R7.2, SW4.5 (VCC), SW5.5 (VCC), U1.8 (V+), U5.3 (EN), U5.4 (IN), U11.3 (OUT)
+12V: C21.1, C23.1, C25.1, D1.2 (K), J5.1, J18.3, R1.2, R2.2, U7.4 (V+), U8.4 (V+)
-12V: C22.2, C24.2, C26.2, D2.1 (A), J5.2, R3.2, U7.11 (V-), U8.11 (V-)
/5VREG_INPUT: C35.1, J18.2, U11.1 (IN)
/+2.048VREF: C3.1, R2.1, SW4.1 (B1), SW5.1 (B1), U2.2 (A)
/+3.3V_FRONT: J1.15, OLED1.8 (3V3), P2.3, P3.3
/+4.096VREF: C2.1, R1.1, SW4.3 (B0), SW5.3 (B0), U12.2 (A)
/+5V_EURO: D5.1 (A), J11.11, J11.12
/+5V_FRONT: J1.16, LED1.4 (VDD), LED2.4 (VDD), LED3.4 (VDD), LED4.4 (VDD), LED5.4 (VDD), LED6.4 (VDD), LED7.4 (VDD), LED8.4 (VDD), LED9.4 (VDD), LED10.4 (VDD), LED11.4 (VDD), LED12.4 (VDD)
/-10VREF: C4.1, R3.1, R20.1, R22.1, R35.1, R37.1, U3.2 (A)
/ADC_ADVDD: C17.1, R24.1
/ADC_INPUT_1: R25.2, U9.1, U10.1 (CH1+)
/ADC_INPUT_2: R40.2, U9.7, U10.3 (CH2+)
/ADC_INPUT_3: R26.2, U9.8, U10.11 (CH3+)
/ADC_INPUT_4: R39.2, U9.14, U10.13 (CH4+)
/ADC_VDD: U4.43 (ADC_AVDD)
/ADC_VREF: R24.2, R60.1
/AGND_FRONT: J1.5, NT1.1, P2.1, P3.1
/BOOTSEL: J22.7, R11.2, SW3.1 (A)
/BUTTON_1: J5.13, U4.6 (GPIO4)
/BUTTON_1_FRONT: J1.13, SW1.1
/BUTTON_2: J5.12, U4.7 (GPIO5)
/BUTTON_2_FRONT: J1.12, SW2.1
/CV_INPUT_1: J5.6, R21.1
/CV_INPUT_1_FRONT: J1.6, J3.3 (T)
/CV_INPUT_2: J5.7, R38.1
/CV_INPUT_2_FRONT: J1.7, J10.3 (T)
/CV_INPUT_3: J5.8, R23.1
/CV_INPUT_3_FRONT: J1.8, J4.3 (T)
/CV_INPUT_4: J5.9, R36.1
/CV_INPUT_4_FRONT: J1.9, J9.3 (T)
/CV_OUTPUT_1: J8.2, R18.1
/CV_OUTPUT_1_FRONT: J2.2, J6.3 (T)
/CV_OUTPUT_2: J8.3, R33.1
/CV_OUTPUT_2_FRONT: J2.3, J12.3 (T)
/CV_OUTPUT_3: J8.4, R47.1
/CV_OUTPUT_3_FRONT: J2.4, J14.3 (T)
/CV_OUTPUT_4: J8.5, R56.1
/CV_OUTPUT_4_FRONT: J2.5, J16.3 (T)
/CV_OUTPUT_5: J8.6, R19.1
/CV_OUTPUT_5_FRONT: J2.6, J7.3 (T)
/CV_OUTPUT_6: J8.7, R34.1
/CV_OUTPUT_6_FRONT: J2.7, J13.3 (T)
/CV_OUTPUT_7: J8.8, R48.1
/CV_OUTPUT_7_FRONT: J2.8, J15.3 (T)
/CV_OUTPUT_8: J8.9, R57.1
/CV_OUTPUT_8_FRONT: J2.9, J17.3 (T)
/DAC_1_OFFSET: R9.1, R12.2, R27.2, R41.2, R49.2, U1.1
/DAC_1_OFFSET_INVERTED: R8.2, SW4.4 (A)
/DAC_1_OUTA: DAC1.6 (VOUTA), R13.2
/DAC_1_OUTB: DAC1.7 (VOUTB), R28.2
/DAC_1_OUTC: DAC1.8 (VOUTC), R42.2
/DAC_1_OUTD: DAC1.9 (VOUTD), R50.2
/DAC_1_OUTPUT_MODE: SW4.6 (SEL), U4.13 (GPIO10)
/DAC_1_RDY: DAC1.5 (RDY/~BSY)
/DAC_2_OFFSET: R14.2, R29.2, R43.2, R51.2, R61.1, U1.7
/DAC_2_OFFSET_INVERTED: R55.2, SW5.4 (A)
/DAC_2_OUTA: DAC2.6 (VOUTA), R15.2
/DAC_2_OUTB: DAC2.7 (VOUTB), R30.2
/DAC_2_OUTC: DAC2.8 (VOUTC), R44.2
/DAC_2_OUTD: DAC2.9 (VOUTD), R52.2
/DAC_2_OUTPUT_MODE: SW5.6 (SEL), U4.14 (GPIO11)
/DAC_2_RDY: DAC2.5 (RDY/~BSY)
/GND_FRONT: J1.3, J1.4, J1.14, J2.1, J2.14, J2.15, J2.16, J3.1 (E), J4.1 (E), J6.1 (E), J7.1 (E), J9.1 (E), J10.1 (E), J12.1 (E), J13.1 (E), J14.1 (E), J15.1 (E), J16.1 (E), J17.1 (E), LED1.2 (VSS), LED2.2 (VSS), LED3.2 (VSS), LED4.2 (VSS), LED5.2 (VSS), LED6.2 (VSS), LED7.2 (VSS), LED8.2 (VSS), LED9.2 (VSS), LED10.2 (VSS), LED11.2 (VSS), LED12.2 (VSS), NT1.2, OLED1.7 (GND), SW1.2, SW2.2
/GPIO_25_LED: R62.1, U4.37 (GPIO25)
/I2C0_SCL: DAC1.2 (SCL), J8.13, U4.3 (GPIO1), U10.8 (SCL)
/I2C0_SCL_FRONT: J2.13, OLED1.6 (SCK)
/I2C0_SDA: DAC1.3 (SDA), J8.12, U4.2 (GPIO0), U10.7 (SDA)
/I2C0_SDA_FRONT: J2.12, OLED1.5 (SDA)
/I2C1_SCL: DAC2.2 (SCL), J22.11, U4.5 (GPIO3)
/I2C1_SDA: DAC2.3 (SDA), J22.10, U4.4 (GPIO2)
/INPUT_DETECT: D3.2 (A), D4.1 (K), J8.10, U4.16 (GPIO13)
/INPUT_DETECT_FRONT: J2.10, J3.2 (TN), J4.2 (TN), J9.2 (TN), J10.2 (TN)
/KNOB_1: J5.11, U4.38 (GPIO26_ADC0)
/KNOB_1_FRONT: J1.11, P2.2
/KNOB_2: J5.10, U4.39 (GPIO27_ADC1)
/KNOB_2_FRONT: J1.10, P3.2
/NEOPIXEL_DATA_3V3: Q1.2 (S), R6.1, U4.15 (GPIO12)
/NEOPIXEL_DATA_5V: J8.11, Q1.3 (D), R7.1
/NEOPIXEL_DATA_FRONT: J2.11, LED1.3 (DIN)
/QSPI_CS: R10.2, R11.1, U4.56 (QSPI_SS), U6.1 (~CS)
/QSPI_SCLK: U4.52 (QSPI_SCLK), U6.6 (CLK)
/QSPI_SD0: U4.53 (QSPI_SD0), U6.5 (DI(IO0))
/QSPI_SD1: U4.55 (QSPI_SD1), U6.2 (DO(IO1))
/QSPI_SD2: U4.54 (QSPI_SD2), U6.3 (IO2)
/QSPI_SD3: U4.51 (QSPI_SD3), U6.7 (IO3)
/RUN: J22.6, U4.26 (RUN)
/SWCLK: J22.1, U4.24 (SWCLK)
/SWDIO: J22.3, U4.25 (SWD)
/USB_DETECT: R58.1, R59.2, U4.36 (GPIO24)
/USB_DN: P1.A7 (D-), R5.1
/USB_DP: P1.A6 (D+), R4.1
/USB_VDD: U4.48 (USB_VDD)
/VBUS: D6.2 (A), P1.A4 (VBUS), P1.A9 (VBUS), P1.B4 (VBUS), P1.B9 (VBUS), R58.2
/XTAL_IN: C8.2, U4.20 (XIN), Y1.1
/XTAL_OUT: C9.2, U4.21 (XOUT), Y1.3
Earth: C1.2, C2.2, C3.2, C4.2, C5.2, C6.2, C7.2, C8.1, C9.1, C10.2, C13.2, C14.2, C15.2, C16.2, C17.2, C18.2, C21.2, C22.1, C23.2, C24.1, C25.2, C26.1, C27.2, C28.2, C31.2, C35.2, C36.2, C37.2, C38.2, C39.2, C40.2, C41.2, D4.2 (A), D7.1 (K), DAC1.10 (VSS), DAC2.10 (VSS), J5.3, J5.4, J5.5, J5.14, J8.1, J8.14, J8.15, J8.16, J11.3, J11.4, J11.5, J11.6, J11.7, J11.8, J22.2, J22.4, J22.8, P1.A1 (GND), P1.A12 (GND), P1.B1 (GND), P1.B12 (GND), R59.1, SW3.3 (C), SW4.2 (GND), SW5.2 (GND), U1.3 (+), U1.4 (V-), U1.6 (-), U2.1 (K), U3.1 (K), U4.9 (GPIO7), U4.11 (GPIO8), U4.12 (GPIO9), U4.19 (TESTEN), U4.57 (GND), U5.2 (GND), U5.5 (GND), U6.4 (GND), U7.3 (+), U7.5 (+), U7.10 (+), U7.12 (+), U8.3 (+), U8.5 (+), U8.10 (+), U8.12 (+), U9.2 (-), U9.6 (-), U9.9 (-), U9.11 (V-), U9.13 (-), U10.2 (CH1-), U10.4 (CH2-), U10.5 (VSS), U10.9 (Adr0), U10.10 (Adr1), U10.12 (CH3-), U10.14 (CH4-), U11.2 (GND), U12.1 (K), Y1.2
unnamed: C11.2, R16.1, R18.2, U7.14
unnamed: C12.2, R17.1, R19.2, U8.14
unnamed: C19.2, R31.1, R33.2, U7.1
unnamed: C20.2, R32.1, R34.2, U8.1
unnamed: C29.2, R45.1, R47.2, U7.7
unnamed: C30.2, R46.1, R48.2, U8.7
unnamed: C32.2, R53.1, R56.2, U7.8
unnamed: C33.2, R54.1, R57.2, U8.8
unnamed: D1.1 (A), J11.9, J11.10
unnamed: D2.2 (K), J11.1, J11.2
unnamed: D7.2 (A), R62.2
unnamed: LED1.1 (DOUT), LED3.3 (DIN)
unnamed: LED2.3 (DIN), LED7.1 (DOUT)
unnamed: LED2.1 (DOUT), LED4.3 (DIN)
unnamed: LED3.1 (DOUT), LED5.3 (DIN)
unnamed: LED4.1 (DOUT), LED6.3 (DIN)
unnamed: LED5.1 (DOUT), LED7.3 (DIN)
unnamed: LED6.1 (DOUT), LED8.3 (DIN)
unnamed: LED8.1 (DOUT), LED9.3 (DIN)
unnamed: LED10.3 (DIN), LED11.1 (DOUT)
unnamed: LED10.1 (DOUT), LED12.3 (DIN)
unnamed: LED9.1 (DOUT), LED11.3 (DIN)
unnamed: R8.1, R9.2, U1.2 (-)
unnamed: R55.1, R61.2, U1.5 (+)
unnamed: R5.2, U4.46 (USB_DM)
unnamed: R4.2, U4.47 (USB_DP)
unnamed: C19.1, R27.1, R28.1, R31.2, U7.2 (-)
unnamed: C29.1, R41.1, R42.1, R45.2, U7.6 (-)
unnamed: C32.1, R49.1, R50.1, R53.2, U7.9 (-)
unnamed: C11.1, R12.1, R13.1, R16.2, U7.13 (-)
unnamed: C20.1, R29.1, R30.1, R32.2, U8.2 (-)
unnamed: C30.1, R43.1, R44.1, R46.2, U8.6 (-)
unnamed: C33.1, R51.1, R52.1, R54.2, U8.9 (-)
unnamed: C12.1, R14.1, R15.1, R17.2, U8.13 (-)
unnamed: R20.2, R21.2, R25.1, U9.3 (+)
unnamed: R37.2, R38.2, R40.1, U9.5 (+)
unnamed: R22.2, R23.2, R26.1, U9.10 (+)
unnamed: R35.2, R36.2, R39.1, U9.12 (+)

Notes on the sheet:
OP-AMP POWER
+5V REGULATOR
DAC OFFSET SETTING
DAC_OFFSET is added to the signal to determine if it is unipolar or bipolar.
Crystal
The INPUT_DETECT signal is clamped using two diodes to prevent it from going above 3.3V or below Ground. This is because when a jack is plugged in, the tip of the jack (which may be in the range of ±10V) will briefly contact the switched pin, so the RP2040 pin must be protected
The DAC_X_OFFSET signals are inverted to make them negative for use in the DAC output circuit
OUTPUT_MODE is a digital signal from the RP2040 that can be set in code to determine the polarity of the outputs: 0 - unipolar 0-10V 1 - bipolar ±5V
PIN45
PIN44
+3.3V REGULATOR
The internal +3.3V regulator is used to generate the supply for the RP2040, which is also used for the buttons and knobs
In bipolar mode, the signal is offset by -2.048V, resulting in a signal from -2.048V to +2.048V It is then inverted and amplified by 2.7x resulting in a signal from +5.53VV to -5.53V (the clipping to ±5V and flipping of direction happens in software)
USB
PIN50
GP6 - GP9 are used as a binary signal that represents the EuroPi hardware type 0000 - EuroPi 0001 - EuroPi X 0010 - Undetermined etc
INPUT ADCS
The signal is split on the PCB into two nets: CV_OUTPUT_X is on the back PCB, and CV_OUTPUT_X_FRONT is on the front PCB Once the module is assembled, these nets are connected through the 2.54mm headers
The male header (above) is used on the front PCB and the female header (below) is used on the back PCB. This is so that in the event the standoff fails or is improperly tightened and the PCBs pull apart in the rack, the power rails that are routed through the headers are not exposed via the male pi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
+2.048V REFERENCE
RP2040
The user can set whether to use the internal +5V regulator by setting the jumper to either power the regulator with +12V or not
INPUTS
The internal +5V regulator is only used if the jumper on the back of the PCB is set to 'no 5V rail' This allows users with a 5V rail to use the likely more powerful +5V regulator in the eurorack supply, thus reducing the strain on the +12V rail and reducing noise by separating analogue and digital 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
PIN22
PIN49
The incoming signal from the DAC is from 0 to 4.096V In unipolar mode, the signal is offset by -4.096V, resulting in a signal from -4.096V to 0V It is then inverted and amplified by 2.7x resulting in a signal from 11.05V to 0V (the clipping to +10V and flipping of direction happens in software)
INPUT DETECTION
If a signal did go above the range of ±10V, it would still be clamped to the rails of the op-amp, which are 0V and +3.3V, so the ADC input is protected for any input
It has the offset of -10V added to it, resulting in a range of -20V to 0V
FLASH
PIN43
PIN42
PIN33
DECOUPLING
KNOBS
Flash
OUTPUT DACS
The capacitor is used to prevent ringing
-10V REFERENCE
Schottky diode prevents reverse powering of the USB connection from the module's internal 5V rail
Despite being powered by a higher level (+5V), the WAS3157B analog switch has a threshold of only 1.8V for logic
Despite being on the same pin header, multiple power and ground pins are included so that separate 2.54mm cables can be used to route the i2c, swd, and run/bootsel groups individually
PIN01
The voltage references are kept positive (>0V) so that a more standard analog switch can be used. They are inverted before use in the output stage
The flash chip is pin compatible with other sizes; the 64 in the part number can be exchanged for other values for different amounts of flash storage W25Q16JVXGIQ - 2 Megabytes (This is used on the Raspberry Pi Pico) W25Q32JVXGIQ - 4 Megabytes W25Q64JVXGIQ - 8 Megabytes (This is used on the EuroPi 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
NEOPIXEL RGB LEDS
Output stage Falstad simulation: https://tinyurl.com/2dm6q32a
It is then inverted and attenuated by 0.15x resulting in a range of +3V to 0V, which is a safe range to feed into the +3.3V tolerant ADC input.
EURORACK POWER
The DACs have a programmable gain which is set to output 0-4.096V. The channel must also be set to 1 in code to use the internal 2.048V reference
i2c bus 1 of the RP2040
Input stage Falstad simulation: https://tinyurl.com/24wc45cd
BUTTONS
Serial Wire Debug
OUTPUTS
EXPANDERS
-4.096V or -2.048V depending on OUTPUT_MODE setting
PIN10
PIN23
PIN HEADERS
The Toadstool Tech Enoki board is used for the OLED as it has a small enough board outline to fit on the front PCB. It is used in i2c mode so the on-board solder jumpers must be bridged. The SPI pins are left unconnected, and the two support headers are soldered but are not connected to any signal
Although the 12V rails are not used on the front panel, they are included on this header for testing purposes
The incoming signal is in the range ±10V
The Neopixel LEDs are serial controlled, meaning only a single pin of the RP2040 is connected to the first LED, and the remaning LEDs are connected in series. They are powered by 5V, but the RP2040 signal is only 3.3V, so a BSS138 MOSFET is used as a level shifter
OLED
VBUS is voltage divided to 3.3v (3.205V) and detected by USB_DETECT to allow code to determine if USB power is active
+4.096V REFERENCE
CRYSTAL

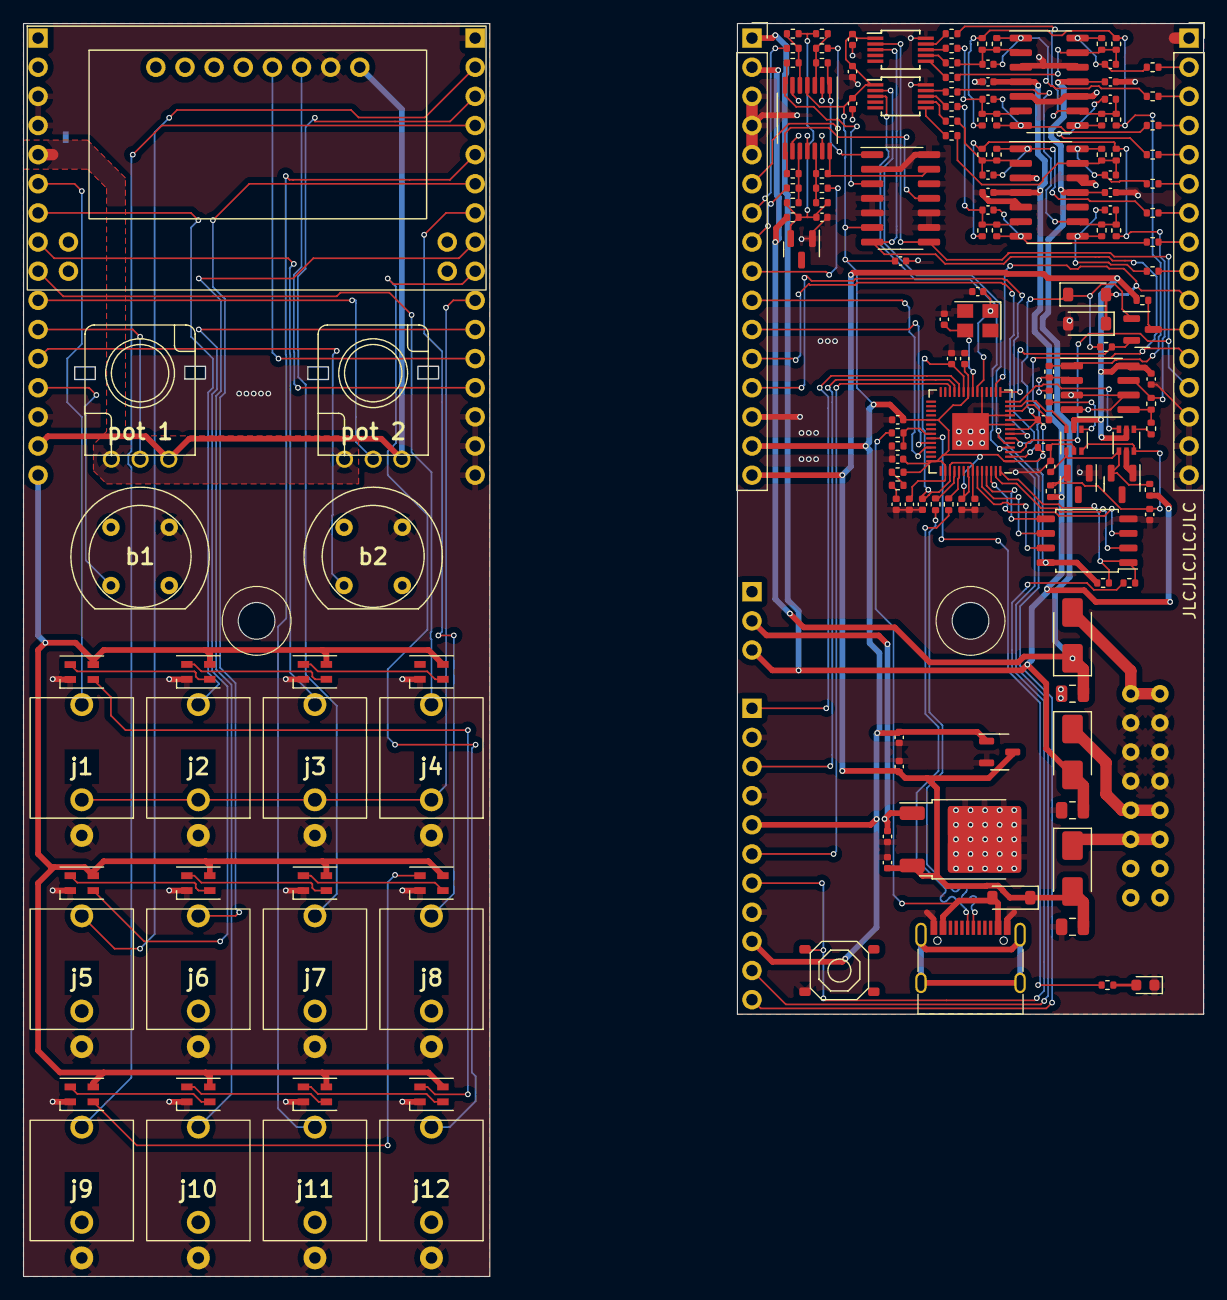
[picture p18: board EuroPi-X.kicad_pcb from above]

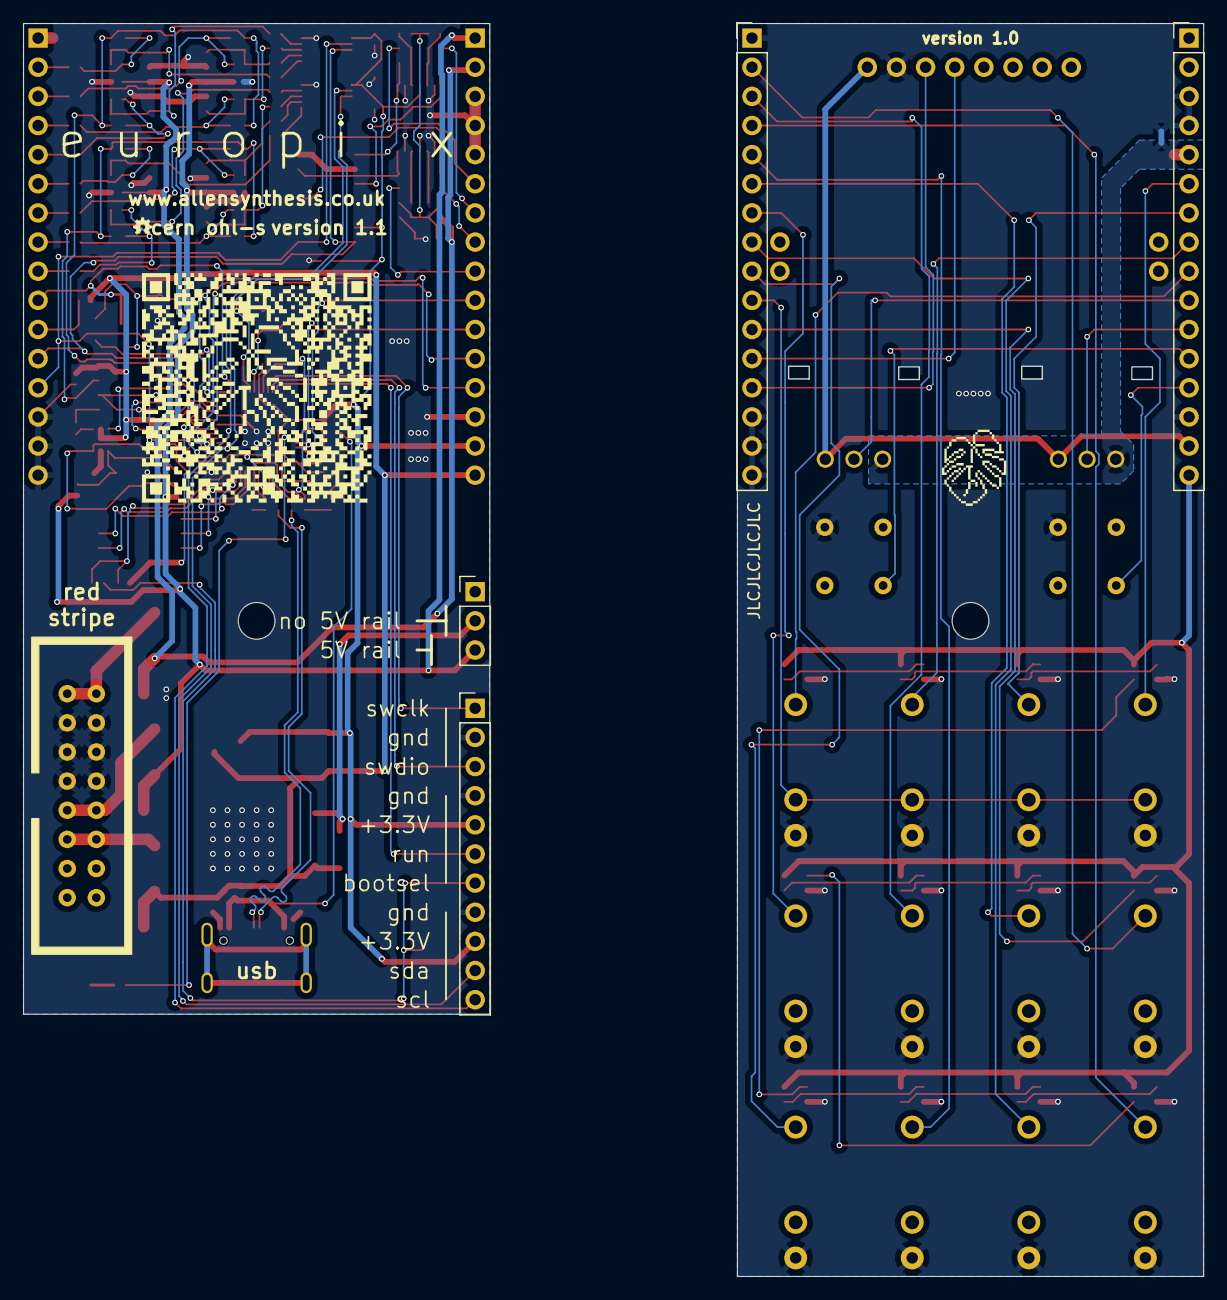
[picture p19: board EuroPi-X.kicad_pcb from below]

Board: 2 copper layers, 40.6 x 86.4 mm, 166 parts (6 on the bottom side), 133 nets.
