roryjamesallen/EuroPi/(notices)

Notices in the files:
hardware/schematic/europi_schematic.kicad_pcb:
LICENSE: CERN OHL-S
hardware/EuroPi-X/kicad/EuroPi-X.kicad_pcb:
cern ohl-s
hardware/surface-mount/europi-surface-mount.kicad_sch:
CC BY-SA 3.0
